cemilkendir/isolated-usb-rs485-rs422-converter/A2_Hardware/PCB_0110_01_AA/out/40_Mechanical/001_Render.jpg

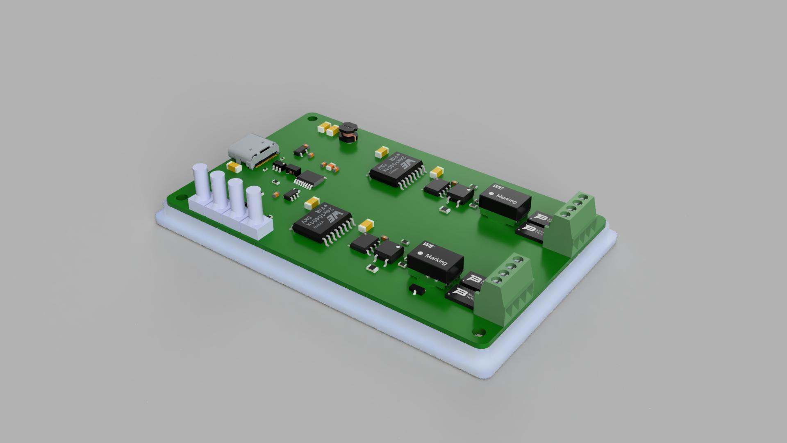
A2_Hardware/PCB_0110_01_AA/out/40_Mechanical/001_Render.jpg
