cemilkendir/isolated-usb-rs485-rs422-converter/A2_Hardware/PCB_0110_01_AA/README/Image/1.PNG

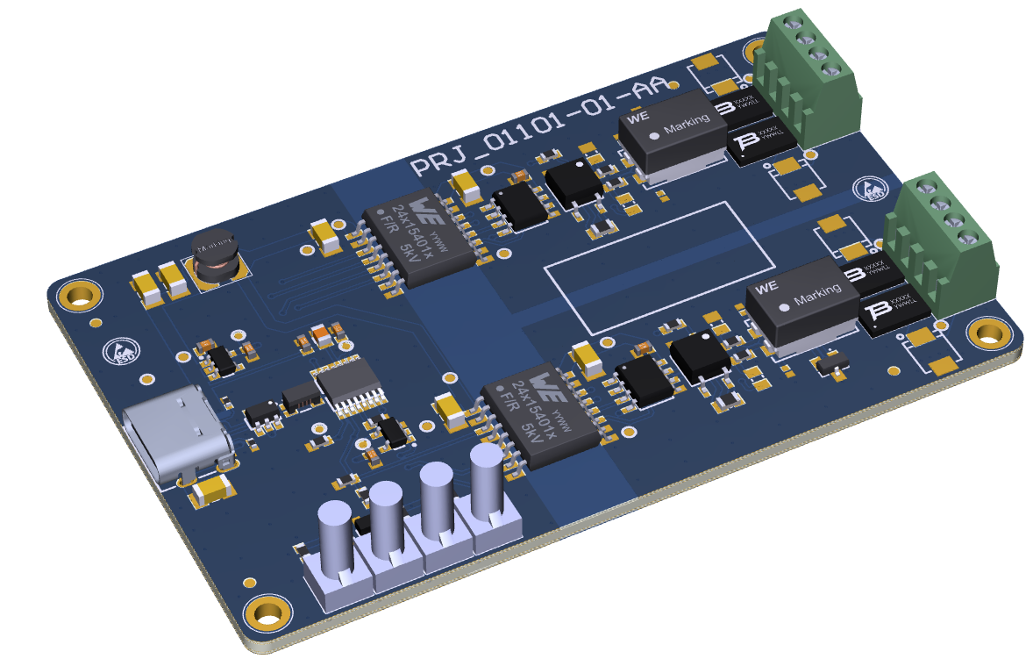
A2_Hardware/PCB_0110_01_AA/README/Image/1.PNG
