cemilkendir/isolated-usb-rs485-rs422-converter/A3_Mechanic/MCH_0110_01_AA/Pic/005_.PNG

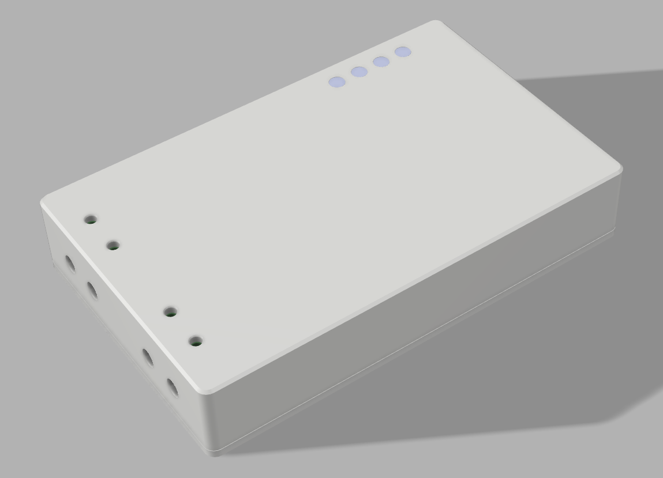
A3_Mechanic/MCH_0110_01_AA/Pic/005_.PNG
