cemilkendir/isolated-usb-rs485-rs422-converter/A2_Hardware/PCB_0110_01_AA/out/10_Bom/BOM_PRJ_01101_01_AAAA.xlsx

Sheet: Project Information
 | SCGC Electronics
USB to RS485_RS422 Converter
Tarih / Date
2026-10-11
23:55:34
PBA Informations
Project Name | USB to RS485_RS422 Converter
Description | USB to RS485_RS422 Converter
Document Number | PRJ_01101
Variant | AA
Release Date | 09/2026
PBA Responsibilities
Drawn by | Cemil Kendir
Checked by | Cemre Kendir
Approved by | Suheyla Inal KENDİR

Sheet: Part List Report
SCGC Electronics |  |  |  | PBA Description: | USB to RS485_RS422 Converter |  |  | Variant: | AA
 |  |  |  | Project Code: | PRJ_0110_AA.PrjPCB |  |  | Total Part Cost:
NO | Stock ID | Purpose Of Usage | Category | Sub-Category | Description | Designator | Quantity | Manufacturer | Manufacturer Part Number | Supplier 1 | Supplier Part Number 1 | Mount | Layer
1 | ?? | BASIC, ISOLATOR | CAPASITOR | CERAMIC | 10UF, 16V, X7R, 1206 | C8, C9, C10_CH_1, C10_CH_2, C11_CH_1, C11_CH_2 | 6 | Samsung | CL31B106MOHNNNE | Digi-Key | 1276-6641-1-ND | SMD | Top
2 | ?? | USB_to_UART | CAPASITOR | CERAMIC | 1nF, 2kV, X7R, 1206 | C1 | 1 | Yageo | CS1206KKX7RDBB102 | Digi-Key | 13-CS1206KKX7RDBB102TR-ND | SMD | Top
3 | ?? | USB_to_UART | CAPASITOR | CERAMIC | 1uF, 50V, X7R, 0603 | C13, C14 | 2 | Yageo | CC0603KRX7R9BB105 | Digi-Key | 311-2082-2-ND | SMD | Top
4 | ?? | USB_to_UART | CAPASITOR | CERAMIC | 10uF ,10V ,X7R ,0805 | C2 | 1 | Yageo | CC0805KFX7R6BB106 | Digi-Key | 13-CC0805KFX7R6BB106CT-ND | SMD | Top
5 | ?? | USB_to_UART, BASIC, RS485 | CAPASITOR | CERAMIC | 100nF, 25V, X7R, 0603 | C3, C4, C7, C12_RS422, C12_RS485 | 5 | Yageo | CC0603KRX7R8BB104 | Digi-Key | 311-1341-1-ND | SMD | Top
6 | ?? | BASIC | CONNECTORS | TERMINAL BLOCK | WR-TBL Terminal block - Rising Cage - THT | CON2, CON3 | 2 | Wurth Elektronik | 691210910004 | Digi-Key | 732-691210910004-ND | SMD | Top
7 | ?? | USB_to_UART | CONNECTORS | USB Type-C | Wr-com_usb 2.0_TYPE C_horizontal | CON1 | 1 | Wurth Elektronik | 629722000214 | Digi-Key | 732-629722000214TR-ND | SMD | Top
8 | ?? | USB_to_UART | DIODE | TVS | WURTH ELEKTRONIK - 824015 - TVS Diode, 82401 Series, Bidirectional, 5 V, 13 V, SOT-23, 6 Pins | TVS3 | 1 | Wurth Electronics | 824015 | Digi-Key | 732-4467-1-ND | SMD | Top
9 | ?? | USB_to_UART | DIODE | LED | LED GREEN CLEAR CHIP SMD | LED1 | 1 | Vishay Lite-On | LTST-C171GKT | Digi-Key | 160-1423-1-ND | SMD | Top
10 | ?? | USB_to_UART | DIODE | LED | LED RED CLEAR SMD | LED2, LED4 | 2 | Vishay Lite-On | LTST-C171KRKT | Digi-Key | 160-1427-1-ND | SMD | Top
11 | ?? | USB_to_UART | DIODE | LED | LED BLUE CLEAR CHIP SMD | LED3 | 1 | Vishay Lite-On | LTST-C171TBKT | Digi-Key | 160-1645-1-ND | SMD | Top
12 | ?? |  | INDUCTORS | FIXED INDUCTORS | WE-PD2, Unshielded Wire-wound SMD Inductor With Ferrite Core, 4.7 Uh, 1.82A I | L1 | 1 | Wurth Elektronik | 744773047 | Digi-Key | 732-1252-1-ND | SMD | Top
13 | ?? | RS485 | INDUCTORS | COMMON MODE CHOKES | Common Mode Chokes Dual 1000uH 6kOhm 100kHz 0.8A 0.207Ohm DCR SMD T/R Automotive AEC-Q200 | CM1_RS422, CM1_RS485 | 2 | Wurth Elektronik | 744222 | Digi-Key | 732-1485-1-ND | SMD | Top
14 | ?? | USB_to_UART | INDUCTORS | COMMON MODE CHOKES | Common Mode Chokes Dual 90Ohm 100MHz 370mA SMD T/R | CM2 | 1 | Wurth Electronics | 744232090 | Digi-Key | 732-1469-1-ND | SMD | Top
15 | ?? | BASIC | INTEGRATED CIRCUITS | LOGIC | MC74VHC1G08 Series 2 to 5.5 SMT Single 2 Input AND Gate - SOT-23-5 | IC3 | 1 | ON Semiconductor | MC74VHC1G08DTT1G | Digi-Key | MC74VHC1G08DTT1GOSTR-ND | SMD | Top
16 | ?? | ISOLATOR | INTEGRATED CIRCUITS | ISOLATOR | WPME-CDIP Capacitive Digital Isolator Powered | IC4_CH_1, IC4_CH_2 | 2 | Wurth Elektronik | 18024115401H | Digi-Key | 732-18024115401HTR-ND | SMD | Top
17 | ?? | RS485 | INTEGRATED CIRCUITS | RS485 DRIVER | 3.0 V to 5.5 V, ±12 kV IEC ESD Protected, Half Duplex 50 Mbps RS-485 Transceiver | IC2_RS422, IC2_RS485 | 2 | Analog Devices | ADM3065EARZ-R7 | Digi-Key | 505-ADM3065EARZ-R7TR-ND | SMD | Top
18 | ?? | RS485 | INTEGRATED CIRCUITS | SOLID STATE RELAY | 1 FORM A SOLID STATE RELAY Transistor Output SSR, 1-Channel, 3750V Isolation | IC5_RS422, IC5_RS485 | 2 | Vishay | VO1400AEFTR | Digi-Key | VO1400AEFTR-ND | SMD | Top
19 | ?? | USB_to_UART | INTEGRATED CIRCUITS | USB to UART | USB Interface IC USB to Basic Serial UART IC SSOP-16 | IC1 | 1 | FTDI | FT230XS-U | Digi-Key | 768-1154-5-ND | SMD | Top
20 | ?? | USB_to_UART | INTEGRATED CIRCUITS | PMIC - LINEAR REGULATOR | Linear Voltage Regulator IC Positive Fixed 1 Output 250mA SOT-23-5 | IC6 | 1 | TEXAS | LP5907MFX-3.3/NOPB | Digi-Key | 296-38557-2-ND | SMD | Top
21 | ?? | BASIC | MECHANICAL | PCB | PCB | PCB1 | 1 | CUSTOM | CUSTOM | CUSTOM | CUSTOM | MECH | Top
22 | ?? | USB_to_UART | MECHANICAL | LED PIPE | Bivar straight light guide, rigidity, PCBinstall, 4.1 x 4.1 x 10.2mm | MCH1, MCH2, MCH3, MCH4 | 4 | Bivar | VLP-400-F | Digi-Key | 492-1516-ND | MECH | Top
23 | ?? | RS485 | PROTECTION | TVS - BI DIRECTIONAL | SM Series 12 V 400 W Asymmetrical TVS Diode for Extended Common-Mode - SOT-23 | TVS1_RS422, TVS1_RS485 | 2 | Semtech | SM712.TCT | Digikey | SM712CT-ND | SMD | Top
24 | ?? | RS485 | PROTECTION | TBU | A Single Bi-Directional, 650V, 200mA, 3-Pin DFN pkg TBU | Bourns TBU-CA065-200-WH | TBU1_RS422, TBU1_RS485, TBU2_RS422, TBU2_RS485 | 4 | Bourns | TBU-CA065-200-WH | Digikey | TBU-CA065-200-WHTR-ND | SMD | Top
25 | ?? | RS485 | RESISTOR | CHIP RESISTOR | 0R ,%1 ,1/10 W ,0603 | R8_RS422, R8_RS485, R9_RS422, R9_RS485 | 4 | YAGEO | RC0603FR-070RL | Digi-Key | 311-0.0HRCT-ND | SMD | Top
26 | ?? | RS485 | RESISTOR | CHIP RESISTOR | 120R, %5, 1/8W, 0805 | R7_RS422, R7_RS485 | 2 | YAGEO | RC0805JR-07120RL | Digi-Key | 311-120ARCT-ND | SMD | Top
27 | ?? | RS485 | RESISTOR | CHIP RESISTOR | 400R, %0.1, 1/8W, 0603 | R11_RS422, R11_RS485 | 2 | Vishay Dale Thin Film | PAT0603E4000BST1 | Digi-Key | PAT0603E4000BST1 | SMD | Top
28 | ?? | USB_to_UART | RESISTOR | CHIP RESISTOR | 5.1K, %1, 1/16W, 0402 | R1, R2 | 2 | YAGEO | RC0402FR-075K1L | Digi-Key | 311-5.10KLRTR-ND | SMD | Top
29 | ?? | USB_to_UART | RESISTOR | CHIP RESISTOR | 10K, %1, 1/10W, 0603 | R13, R14, R15, R16 | 4 | YAGEO | RT0603FRE0710KL | Digi-Key | YAG2321CT-ND | SMD | Top
30 | ?? | USB_to_UART | RESISTOR | CHIP RESISTOR | 220R, %1, 1/10W, 0603 | R3, R4, R5, R12 | 4 | YAGEO | RC0603FR-07220RL | Digi-Key | 311-220HRCT-ND | SMD | Top
31 | ?? | USB_to_UART | TRANSISTOR | NPN | TRANS NPN 45V 0.1A SOT23 | TR1 | 1 | Nexperia | BC847,215 | Digi-Key | 1727-4855-1-ND | SMD | Top
