cemilkendir/isolated-usb-rs485-rs422-converter/A3_Mechanic/MCH_0110_01_AA/MECH/Assembly.step

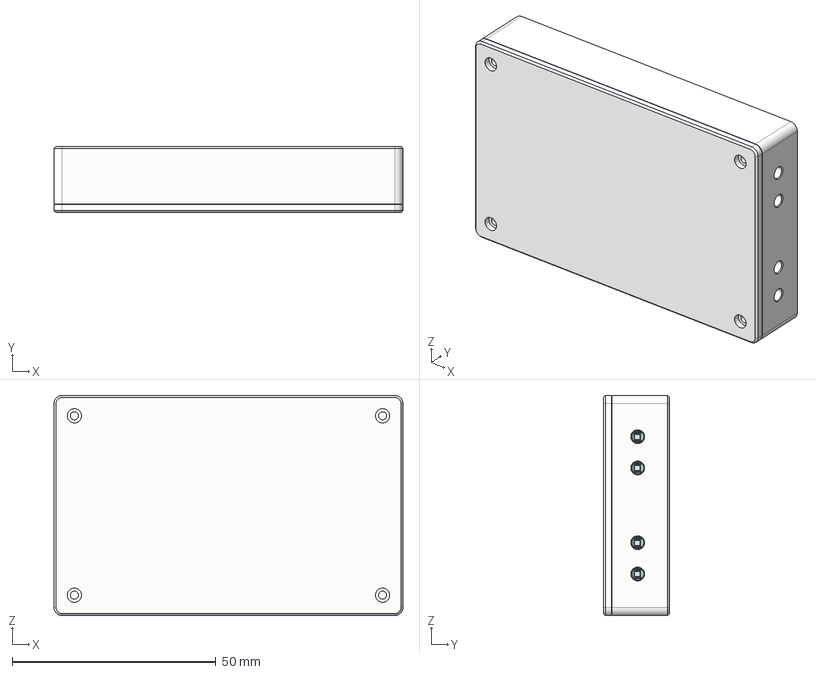
[picture p19: CAD file, 2026-10-11]
A3_Mechanic/MCH_0110_01_AA/MECH/Assembly.step
85.6 x 16.2 x 54.0 mm
BottomCover
6912109100xx_CAGE x 8
6912109100xx_PIN x 8
6912109100xx_VIS x 8
R0603 x 14
SOT-23
tbu-ca x 4
SMD_0402 x 6
ap2112k-3_3trg1 x 2
C0603 x 7
VLP-400-F_1 x 4
Red_0805 x 2
User Library-4-SOP_1 x 2
User Library-4-SOP_2 x 2
User Library-4-SOP_3 x 2
User Library-4-SOP_4 x 2
User Library-4-SOP_5 x 2
User Library-4-SOP_6 x 2
Lötfläche
Lötfläche_1
C1206 x 7
SOT23-6-2
Boden
Blue_0805
Green_0805
STEP-WE-TVS-SOT23-3L-rev1 x 2
R0805 x 2
Housing x 2
Pins x 2
SO8 x 2
SSOP-16_065mm
629722000214_Housing
629722000214_Pin1_Top
629722000214_Pin4_Bottom
629722000214_Pin4_Top x 2
629722000214_Pin1_Bottom
629722000214_Pin3_Bottom
629722000214_Pin3_Top
629722000214_Pin2_Top
629722000214_Pin2_Bottom
629722000214_Pin1_Top_mir
629722000214_Pin1_Bottom_mir
629722000214_Pin2_Top_mir
629722000214_Pin2_Bottom_mir
629722000214_Pin3_Top_mir
629722000214_Pin3_Bottom_mir
629722000214_Pin4_Bottom_mir
629722000214_Shielding2
629722000214_Shielding
Boden_1 x 2
Boden_2 x 2
Boden_3 x 2
Boden_4 x 2
Boden_5 x 2
Deckel x 2
C0805
TopCover
