cemilkendir/isolated-usb-rs485-rs422-converter/A2_Hardware/PCB_0110_01_AA/mech/SPD184.step

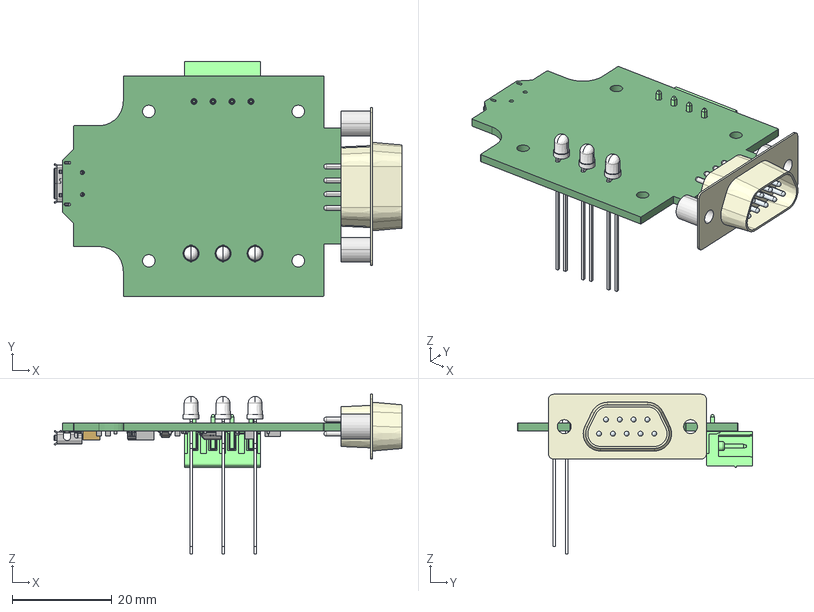
[picture p20: CAD file, 2026-10-05]
A2_Hardware/PCB_0110_01_AA/mech/SPD184.step
69.8 x 47.1 x 32.0 mm
