cemilkendir/isolated-usb-rs485-rs422-converter/A2_Hardware/PCB_0110_01_AA/mech/SPD184 TOP SSEKIL 10.01.2019.dxf

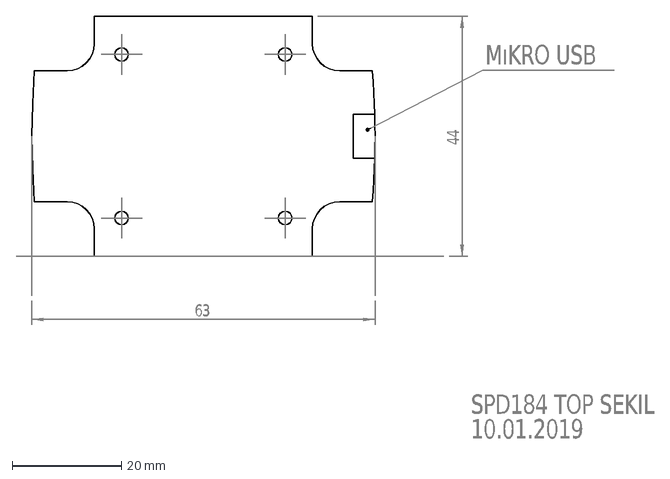
[picture p22: CAD file, 2026-10-05]
A2_Hardware/PCB_0110_01_AA/mech/SPD184 TOP SSEKIL 10.01.2019.dxf
SPD184 TOP SEKIL
10.01.2019
63
44
MıKRO USB
