cemilkendir/isolated-usb-rs485-rs422-converter/A2_Hardware/PCB_0110_01_AA/out/40_Mechanical/3D_Step_PRJ_01101_01_AAAB.step

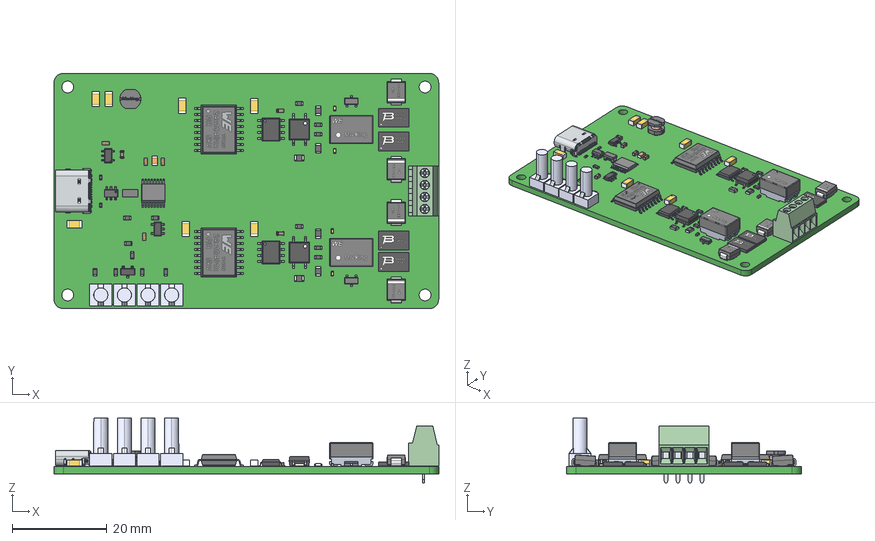
[picture p23: CAD file, 2026-10-05]
A2_Hardware/PCB_0110_01_AA/out/40_Mechanical/3D_Step_PRJ_01101_01_AAAB.step
81.5 x 49.8 x 13.7 mm
R0603 x 14
SOT-23
SMB_DO-214AA x 4
tbu-ca x 4
SMD_0402 x 6
ap2112k-3_3trg1 x 2
C0603 x 7
VLP-400-F x 4
Red_0805 x 2
User Library-4-SOP_1 x 2
User Library-4-SOP_2 x 2
User Library-4-SOP_3 x 2
User Library-4-SOP_4 x 2
User Library-4-SOP_5 x 2
User Library-4-SOP_6 x 2
Lötfläche x 2
C1206 x 7
SOT23-6-2
Boden x 11
Blue_0805
Green_0805
STEP-WE-TVS-SOT23-3L-rev1 x 2
R0805 x 6
Housing x 2
Pins x 2
SO8 x 2
SSOP-16_065mm
6912109100xx_CAGE x 4
6912109100xx_PIN x 4
6912109100xx_VIS x 4
629722000214_Housing
629722000214_Pin1_Top
629722000214_Pin4_Bottom
629722000214_Pin4_Top x 2
629722000214_Pin1_Bottom
629722000214_Pin3_Bottom
629722000214_Pin3_Top
629722000214_Pin2_Top
629722000214_Pin2_Bottom
629722000214_Pin1_Top_mir
629722000214_Pin1_Bottom_mir
629722000214_Pin2_Top_mir
629722000214_Pin2_Bottom_mir
629722000214_Pin3_Top_mir
629722000214_Pin3_Bottom_mir
629722000214_Pin4_Bottom_mir
629722000214_Shielding2
629722000214_Shielding
Deckel x 2
C0805
