cemilkendir/isolated-usb-rs485-rs422-converter/A2_Hardware/PCB_0110_01_AA/mech/HH-042.STEP

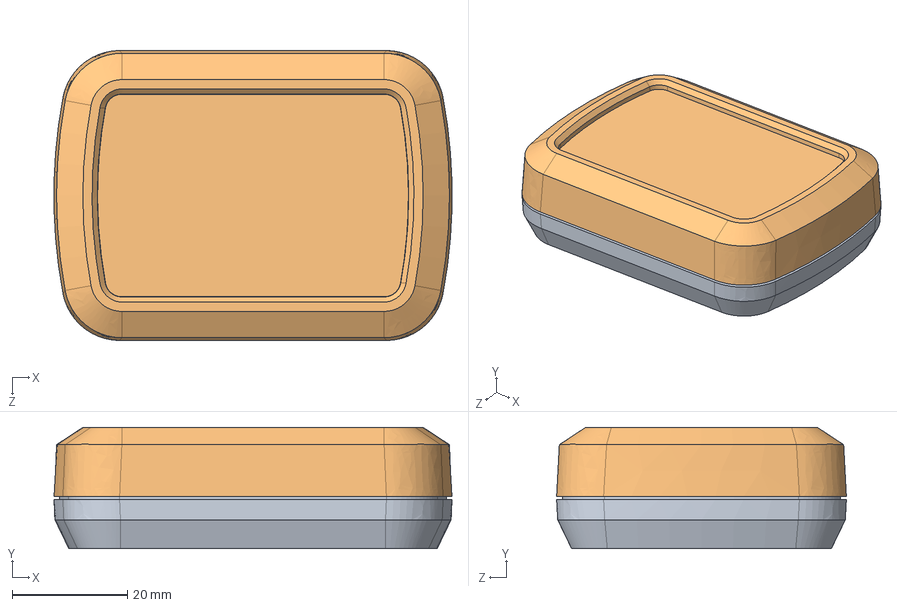
[picture p24: CAD file, 2026-10-05]
A2_Hardware/PCB_0110_01_AA/mech/HH-042.STEP
68.9 x 21.0 x 50.2 mm
HH-042-P-2
HH-042-P-1
