cemilkendir/isolated-usb-rs485-rs422-converter/A3_Mechanic/MCH_0110_01_AA/MECH/BottomCover.step

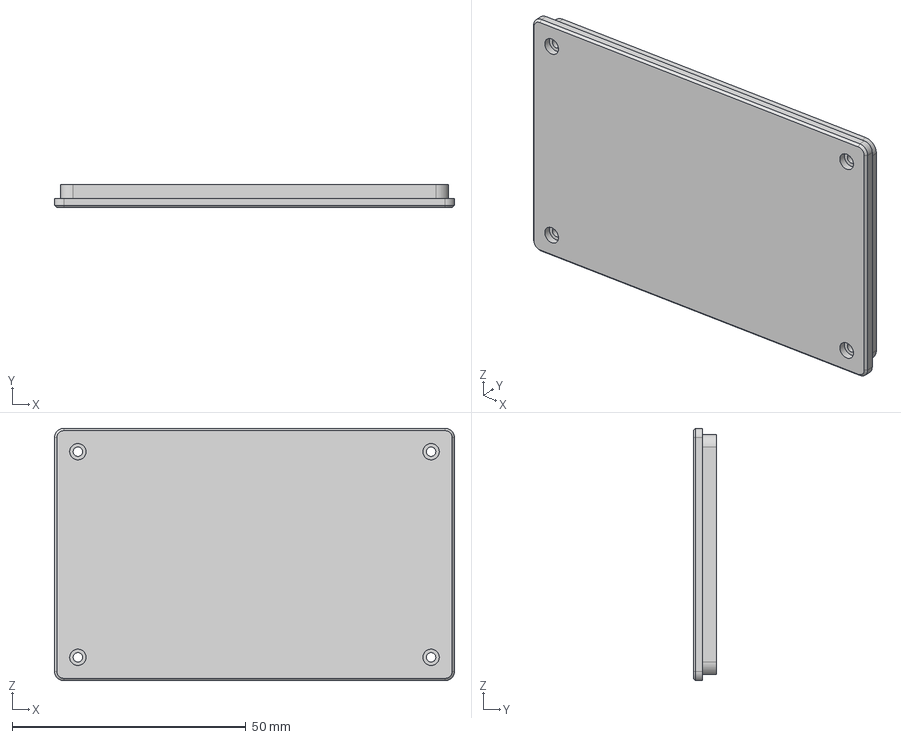
[picture p25: CAD file, 2026-10-11]
A3_Mechanic/MCH_0110_01_AA/MECH/BottomCover.step
85.6 x 5.00 x 54.0 mm
