cemilkendir/isolated-usb-rs485-rs422-converter/A3_Mechanic/MCH_0110_01_AA/MECH/TopCover.step

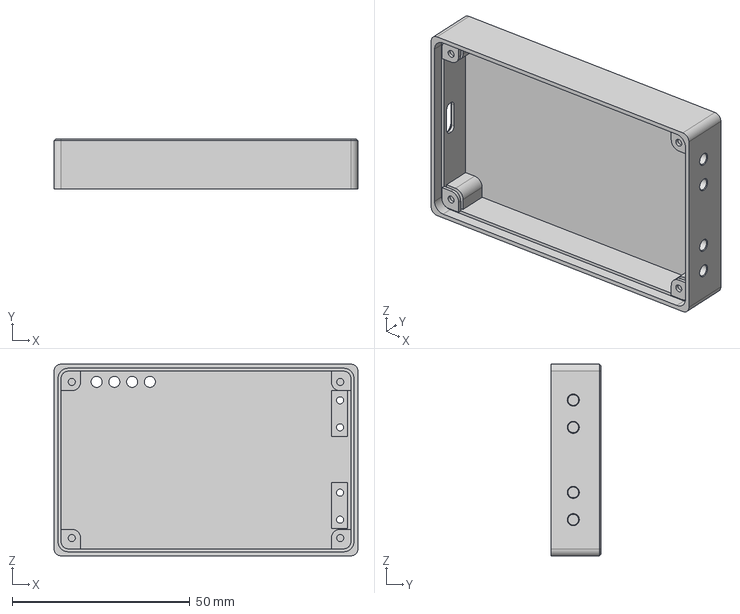
[picture p27: CAD file, 2026-10-11]
A3_Mechanic/MCH_0110_01_AA/MECH/TopCover.step
85.6 x 14.1 x 54.0 mm
