cemilkendir/isolated-usb-rs485-rs422-converter/A2_Hardware/PCB_0110_01_AA/mech/SPD184 KART TOP SEKIL 15.01.2020.dxf

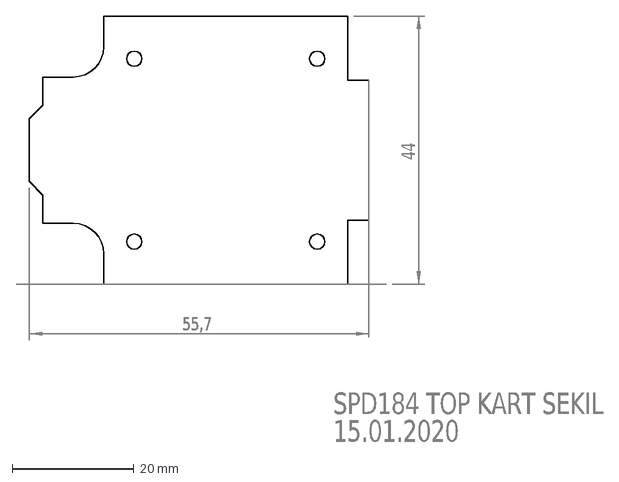
[picture p28: CAD file, 2026-10-05]
A2_Hardware/PCB_0110_01_AA/mech/SPD184 KART TOP SEKIL 15.01.2020.dxf
SPD184 TOP KART SEKIL
15.01.2020
55,7
44
