cemilkendir/isolated-usb-rs485-rs422-converter/(list of files, cad)

Other CAD files:
A3_Mechanic/MCH_0110_01_AA/MECH/3D_Step_PRJ_01101_01_AAAB.step
A2_Hardware/PCB_0110_01_AA/mech/SPD184.x_t
A2_Hardware/PCB_0110_01_AA/mech/SPD184_.step
