cemilkendir/isolated-usb-rs485-rs422-converter/A2_Hardware/PCB_0110_01_AA/out/00_SchPcbPdf/Sch_PRJ_01101_01_AAAA.PDF

D | D
C | C
B | B
A | A

## USB to RS485_RS422 Converter

Rev AA

Header.SchDoc

Sayfa/Sht | 1 | / 5
Form | A4

Tasa/Desig
Kont/Check | Cemre Kendir
Onay/Appr | Suheyla Inal KENDİR Cemil Kendir

## PRJ_01101

Altium Designer 23.9.2

Deg Tarihi/Chng Date

Ortam/Env

Deg Onay/Chng Appr | -
Tarih/Date | 09/2026
(c) 2022 by SCSG Elektronik A.Ş.
All rights Reserved. No part of this document may be produced or transmitted in any form or by any means electronic, mechanical, photocopying, recording, or otherwise, without prior written permission of SCSG.

# PROJECT OVERVIEW

# -This project implements a robust USB 2.0 to RS-485 / RS-422

communication interface intended for industrial and embedded applications.

# -The design provides two independently isolated communication channels for RS-485 and RS-422 operation. Interface selection does not require mechanical switches or jumpers. The receiver paths are automatically combined by utilizing the guaranteed fail-safe HIGH state of the

RS-485/RS-422 transceivers.

# -Galvanic isolation is provided for both communication signals and bus-side power. The RS-485 interface includes software-controlled 120 Ω termination

# USB 2.0 to Isolated RS-485 / RS-422 Converter

# KEY FEATURES

- USB 2.0 Full-Speed interface - FT230X USB-to-UART bridge supporting up to 3 Mbaud - Independent isolated RS-485 and RS-422 channels - ADM3065E true fail-safe RS-485/RS-422 transceivers - Automatic receive-path selection without mechanical switches - Integrated signal and power isolation - Software-controlled 120 Ω termination via RTS - Common-mode filtering on communication lines - Configurable external fail-safe biasing - Multi-stage RS-485 protection using SM712 + TBU - Optional thyristor surge protection stage - Protection and filtering components configurable for EMC optimization - USB-powered operation

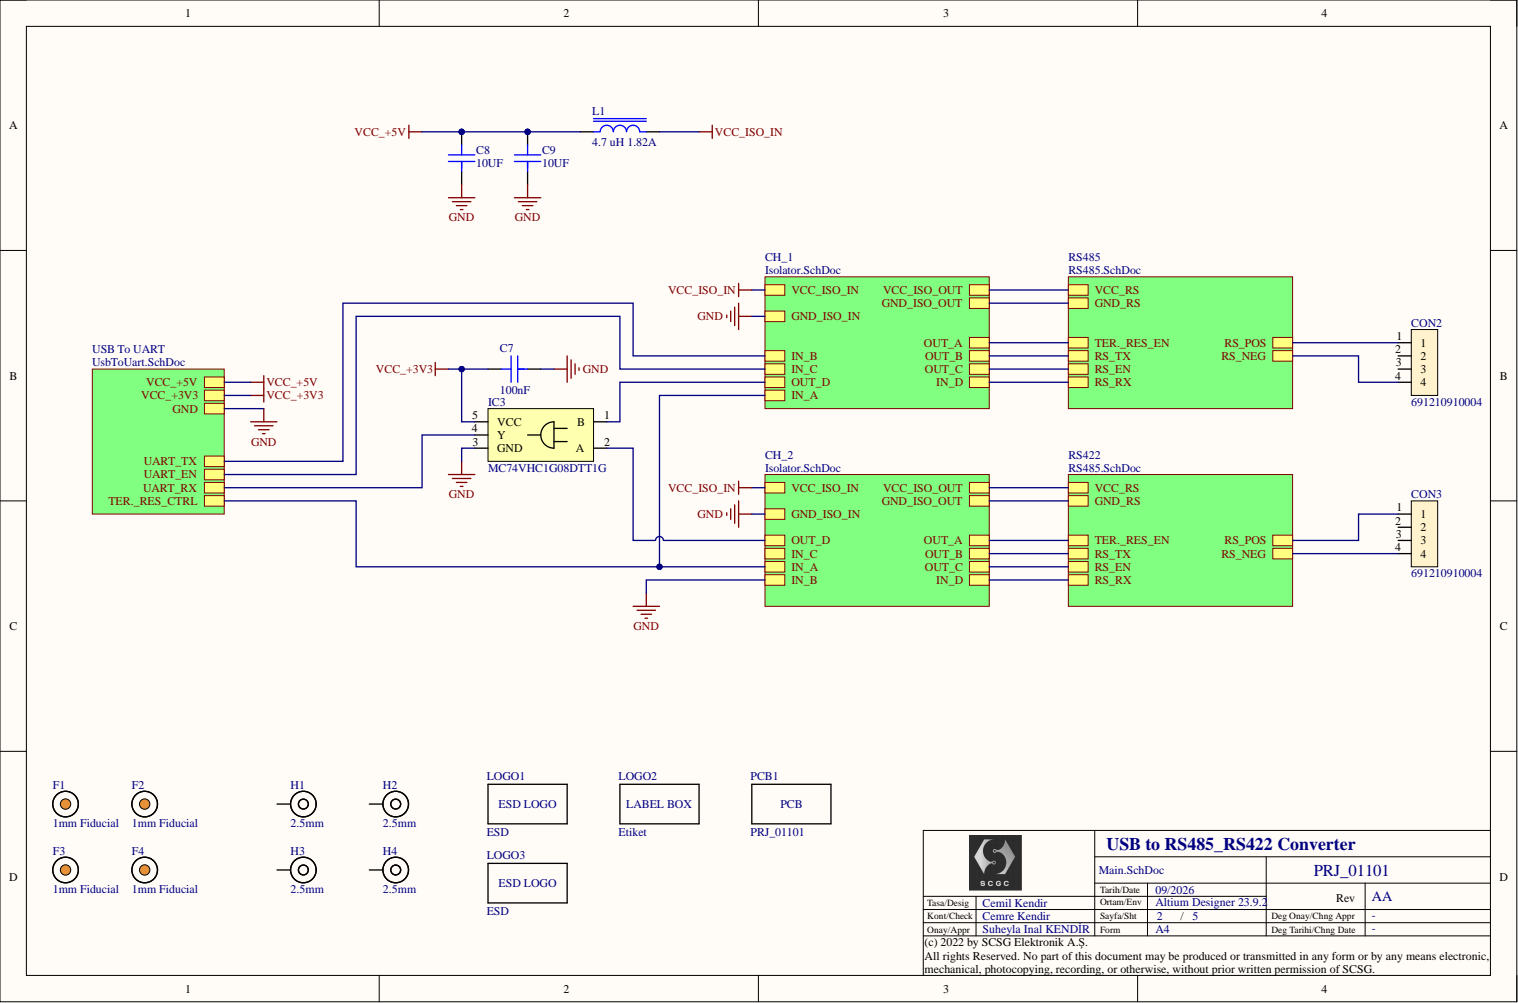
[picture p29: page 2]

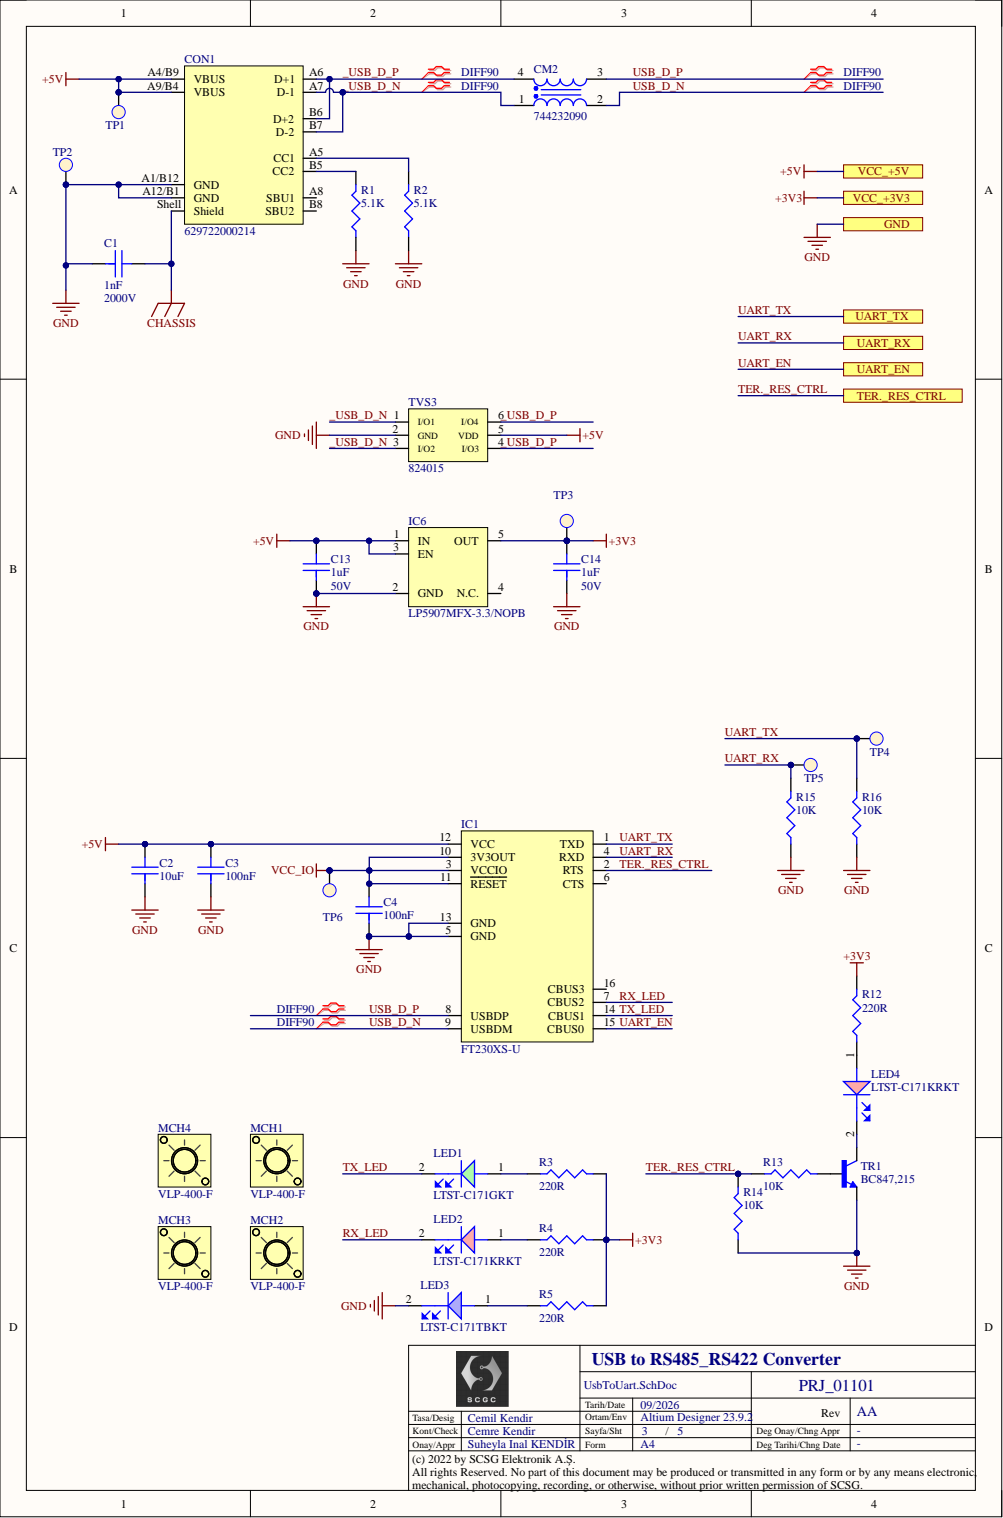
[picture p30: page 3]

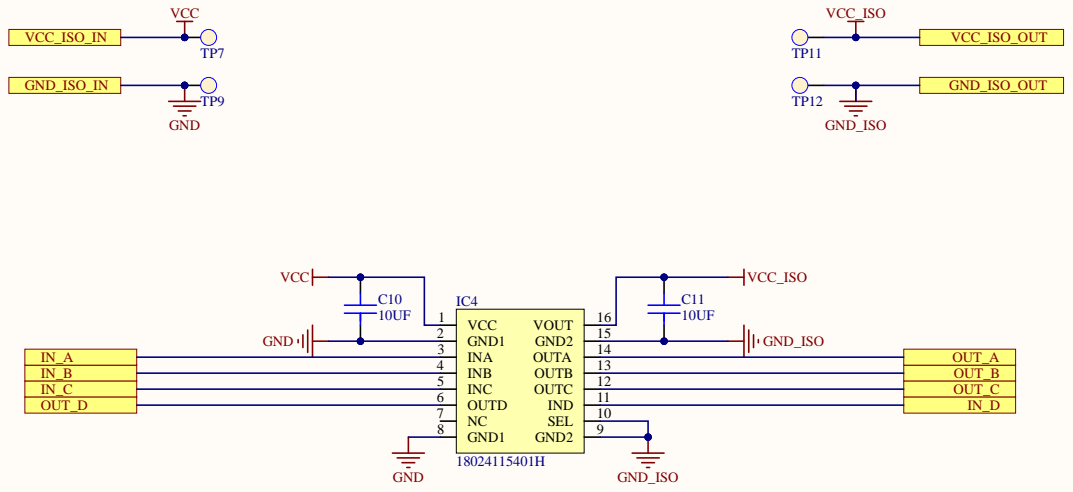
[picture p31: page 4]

IN_C | OUT_C
OUT_D | IN_D

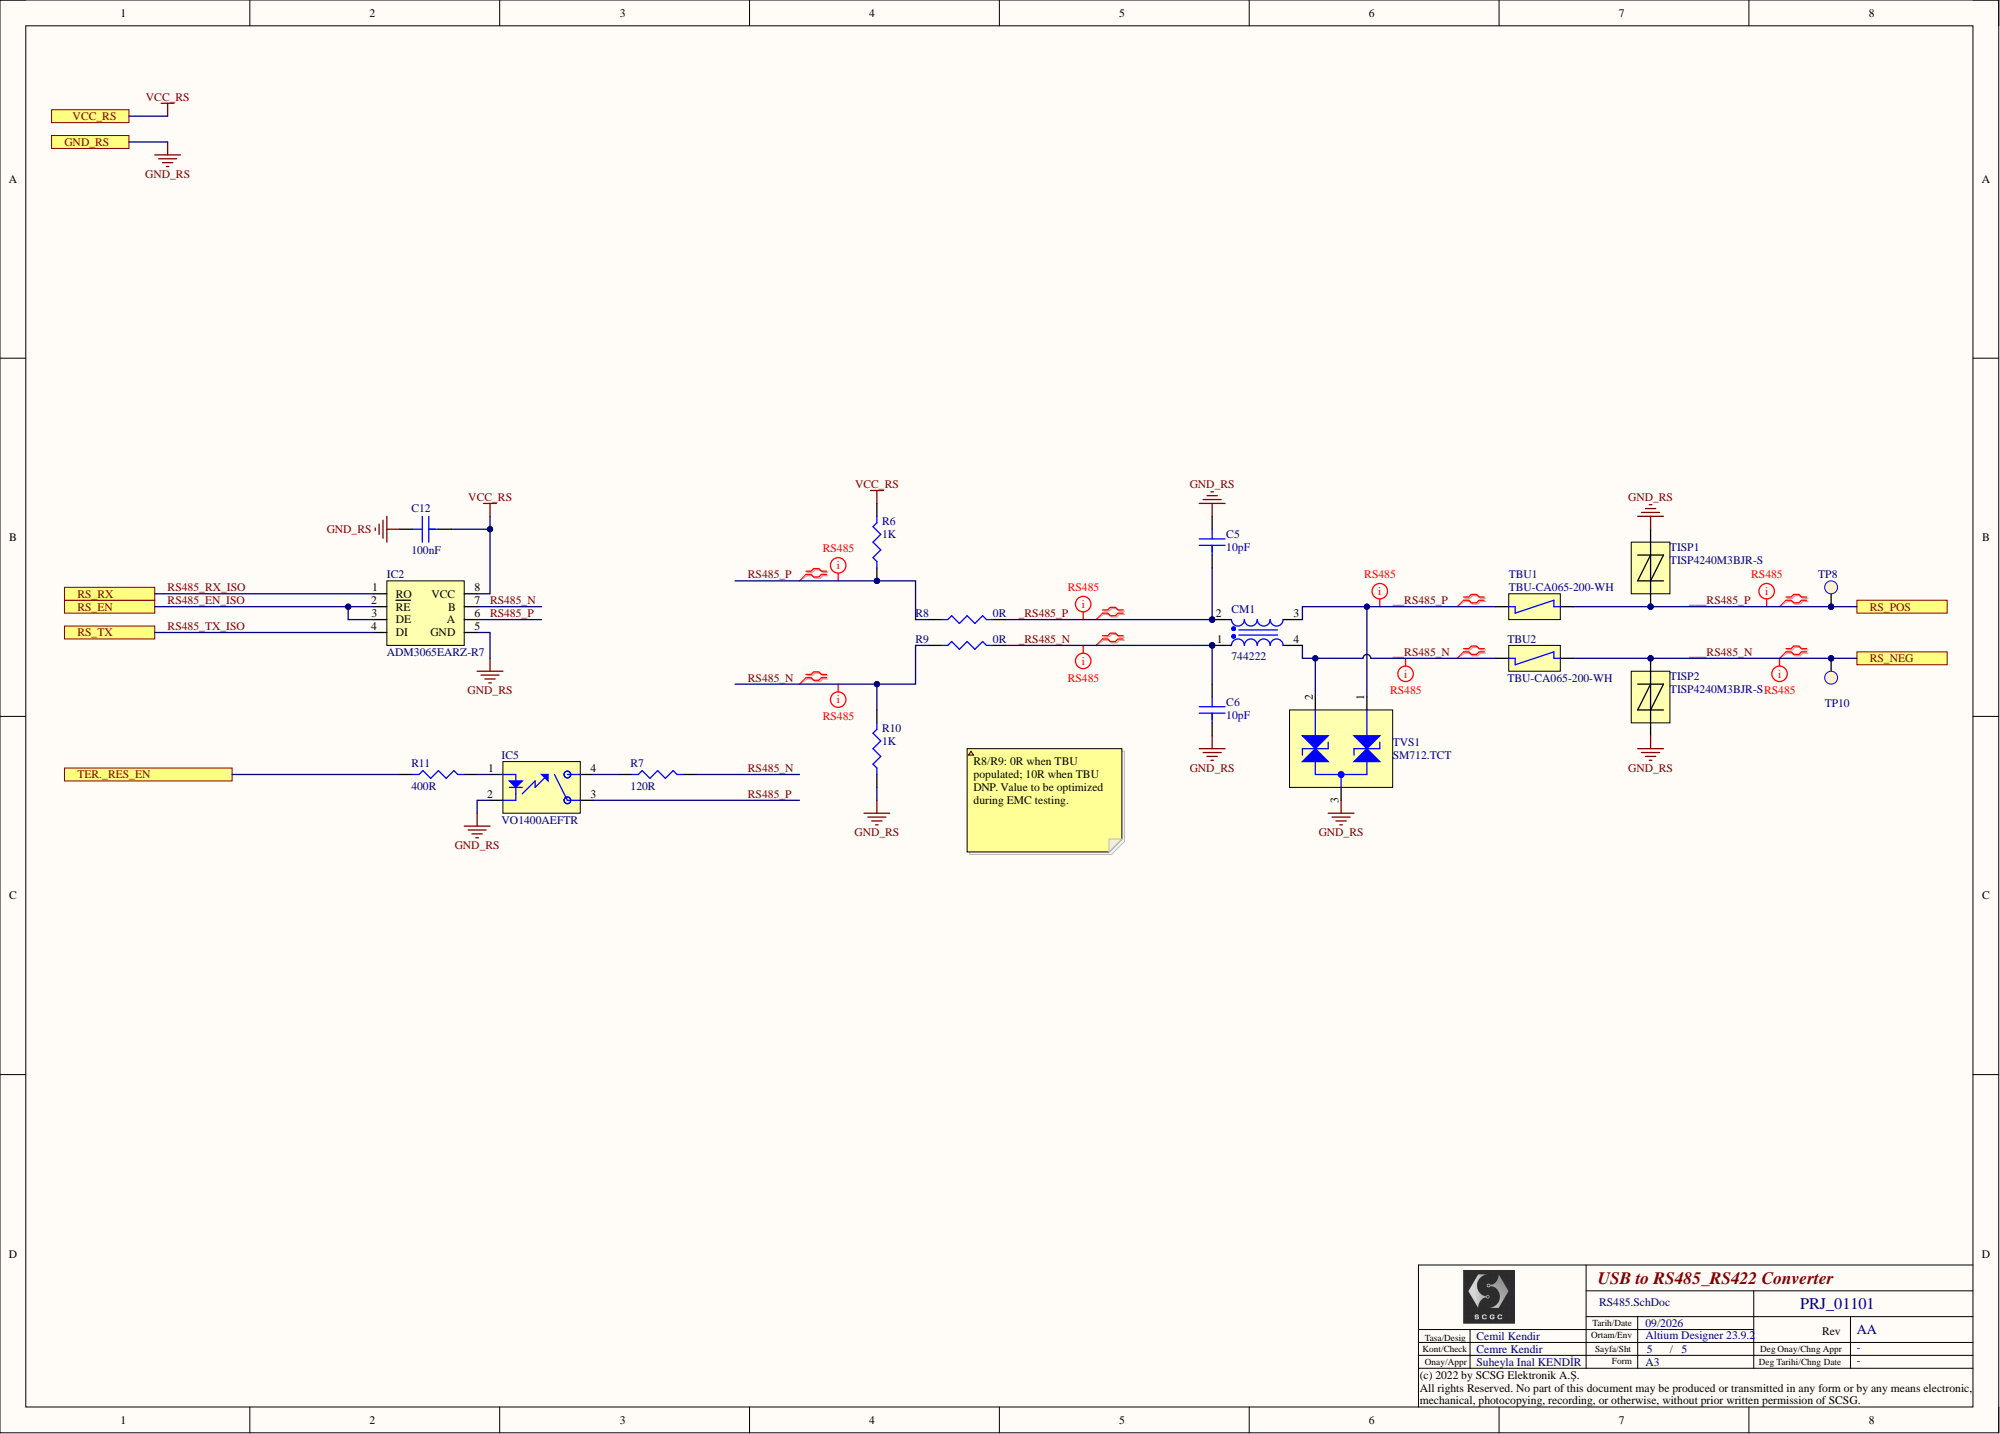
[picture p32: page 5]

R8/R9: 0R when TBU
populated; 10R when TBU
DNP. Value to be optimized
during EMC testing.
