cemilkendir/isolated-usb-rs485-rs422-converter/A2_Hardware/PCB_0110_01_AA/out/00_SchPcbPdf/PCB_PRJ_01101_01_AAAA.PDF

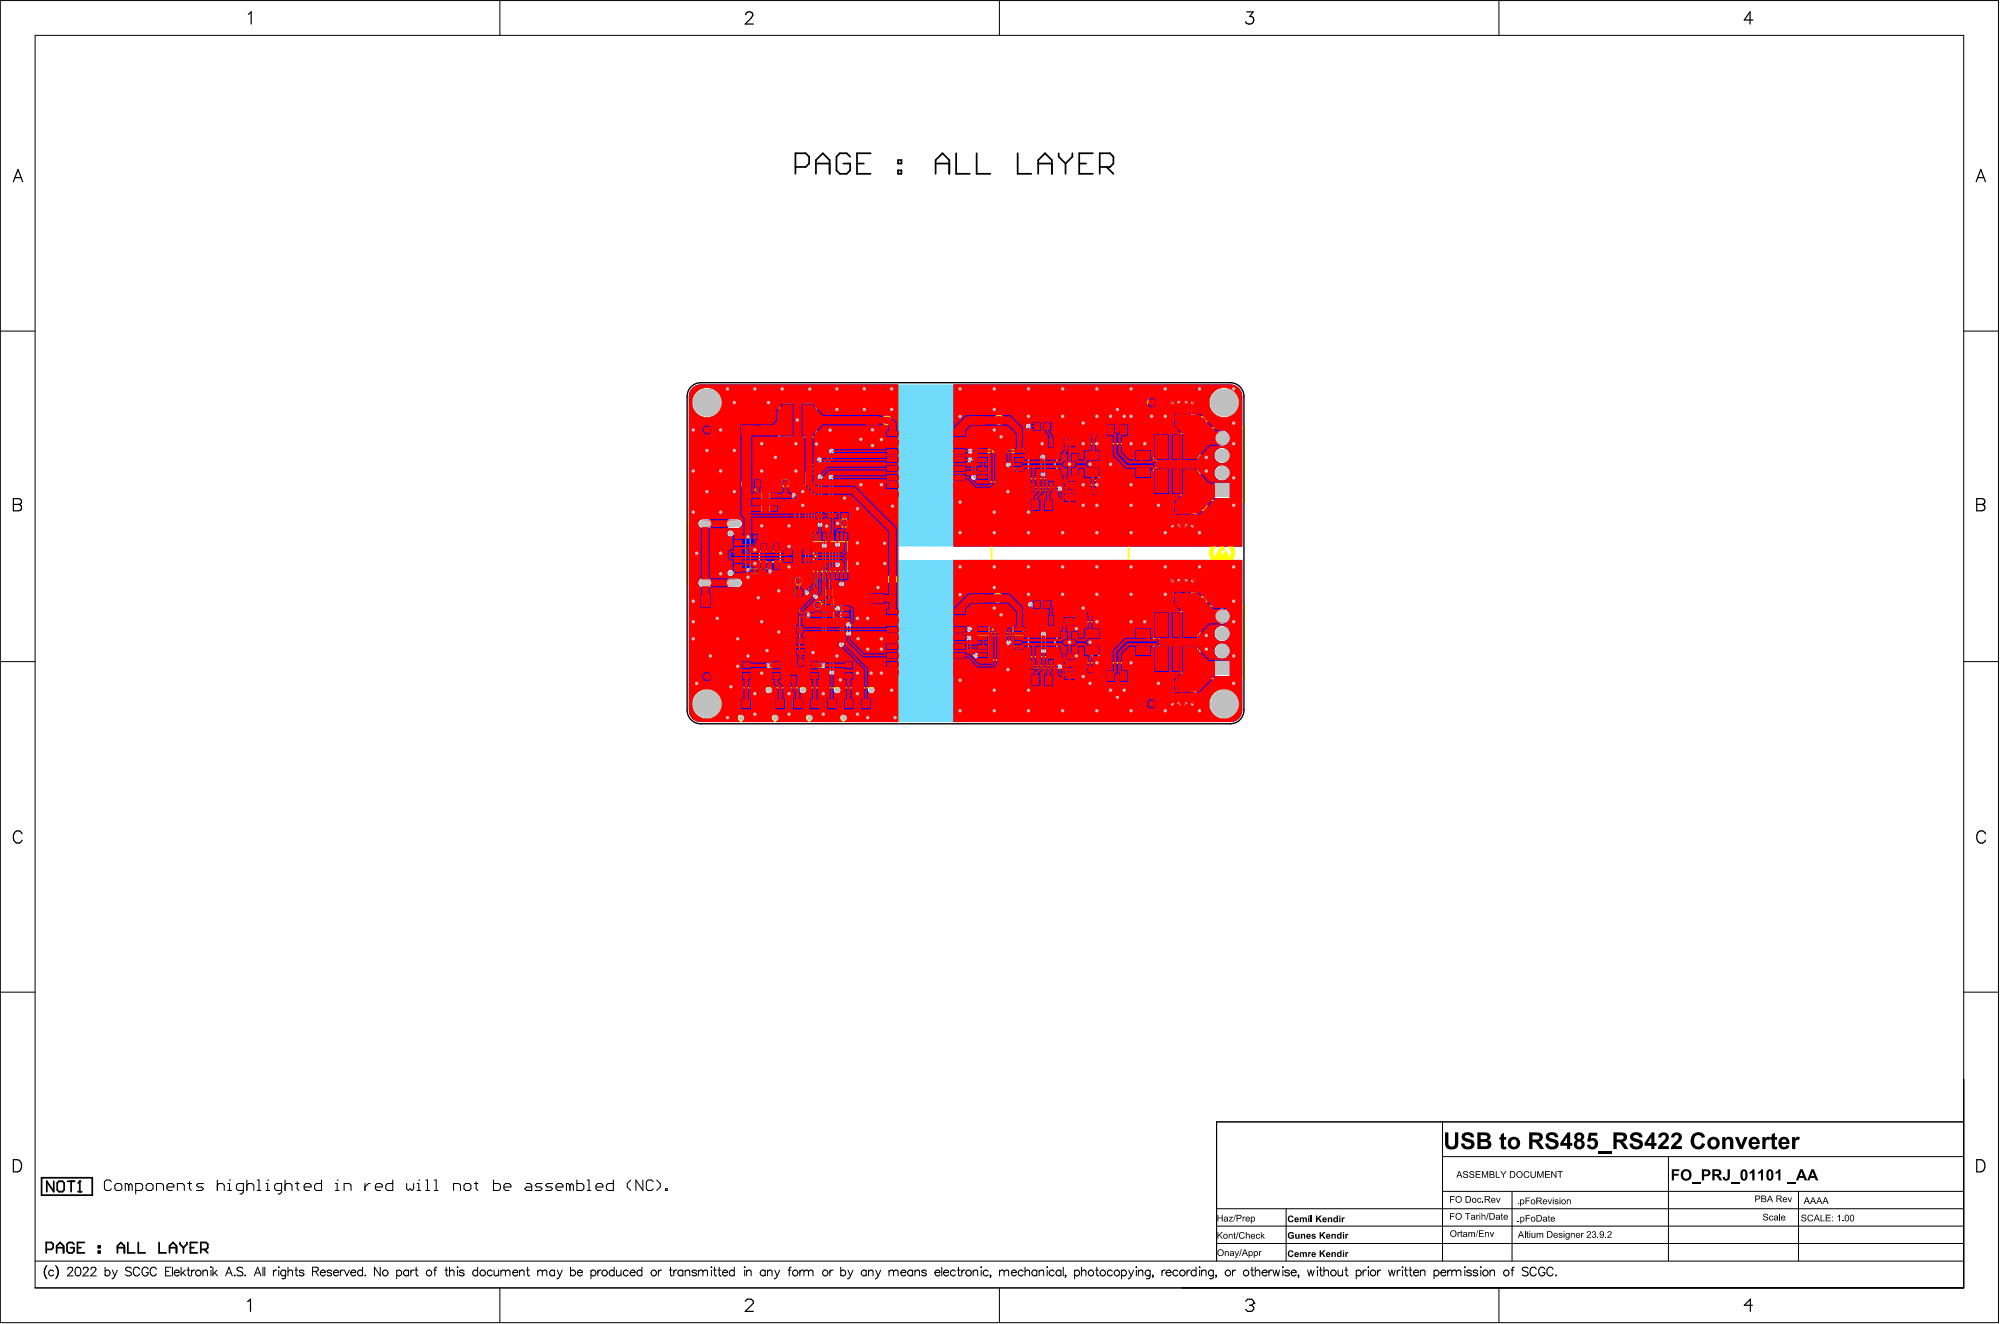
[picture p33: page 1]

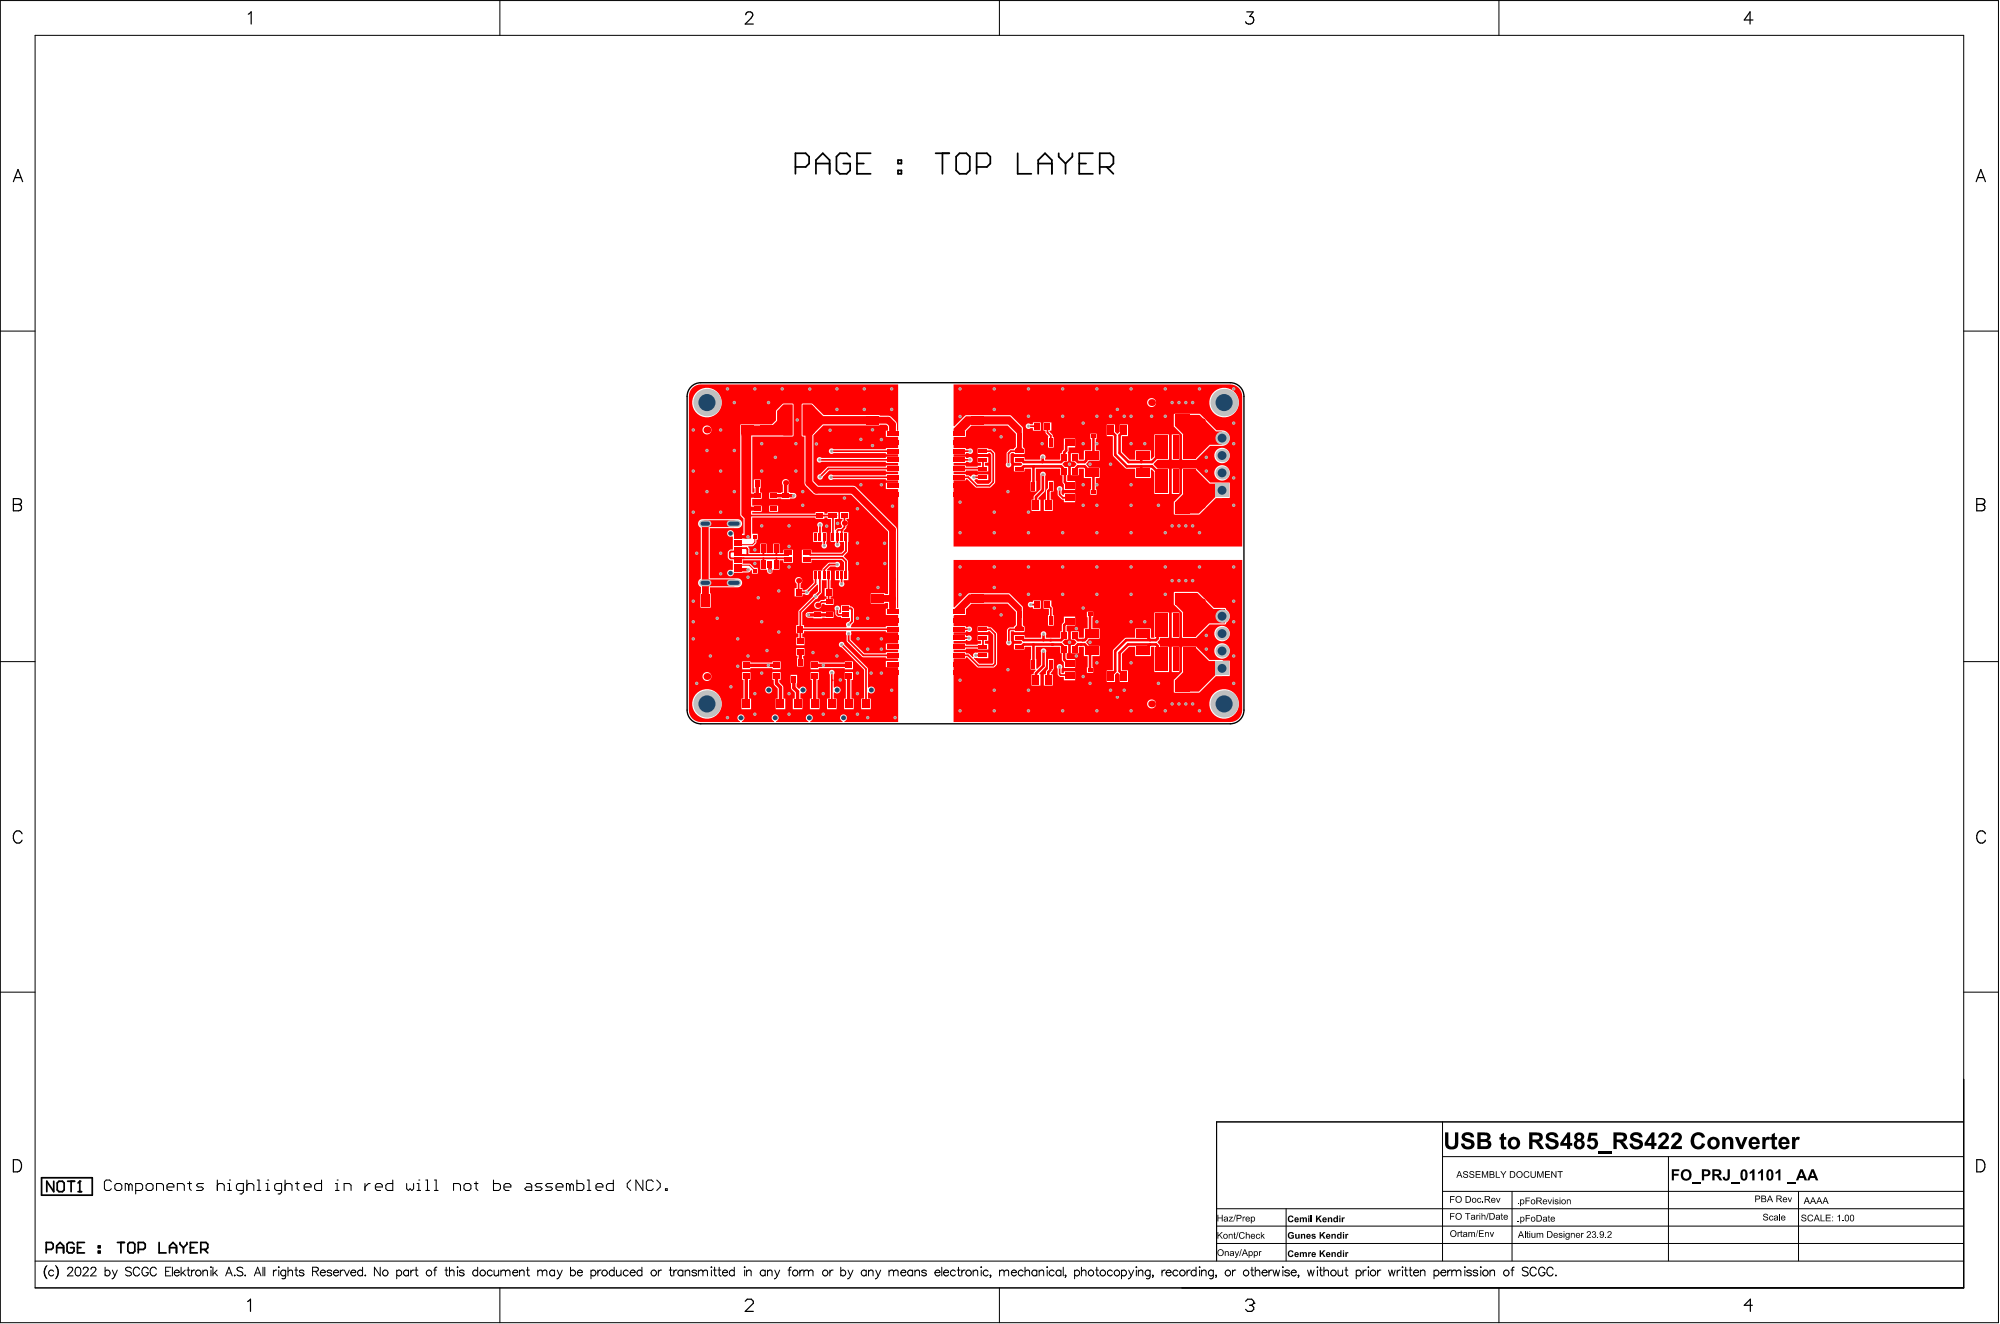
[picture p34: page 2]

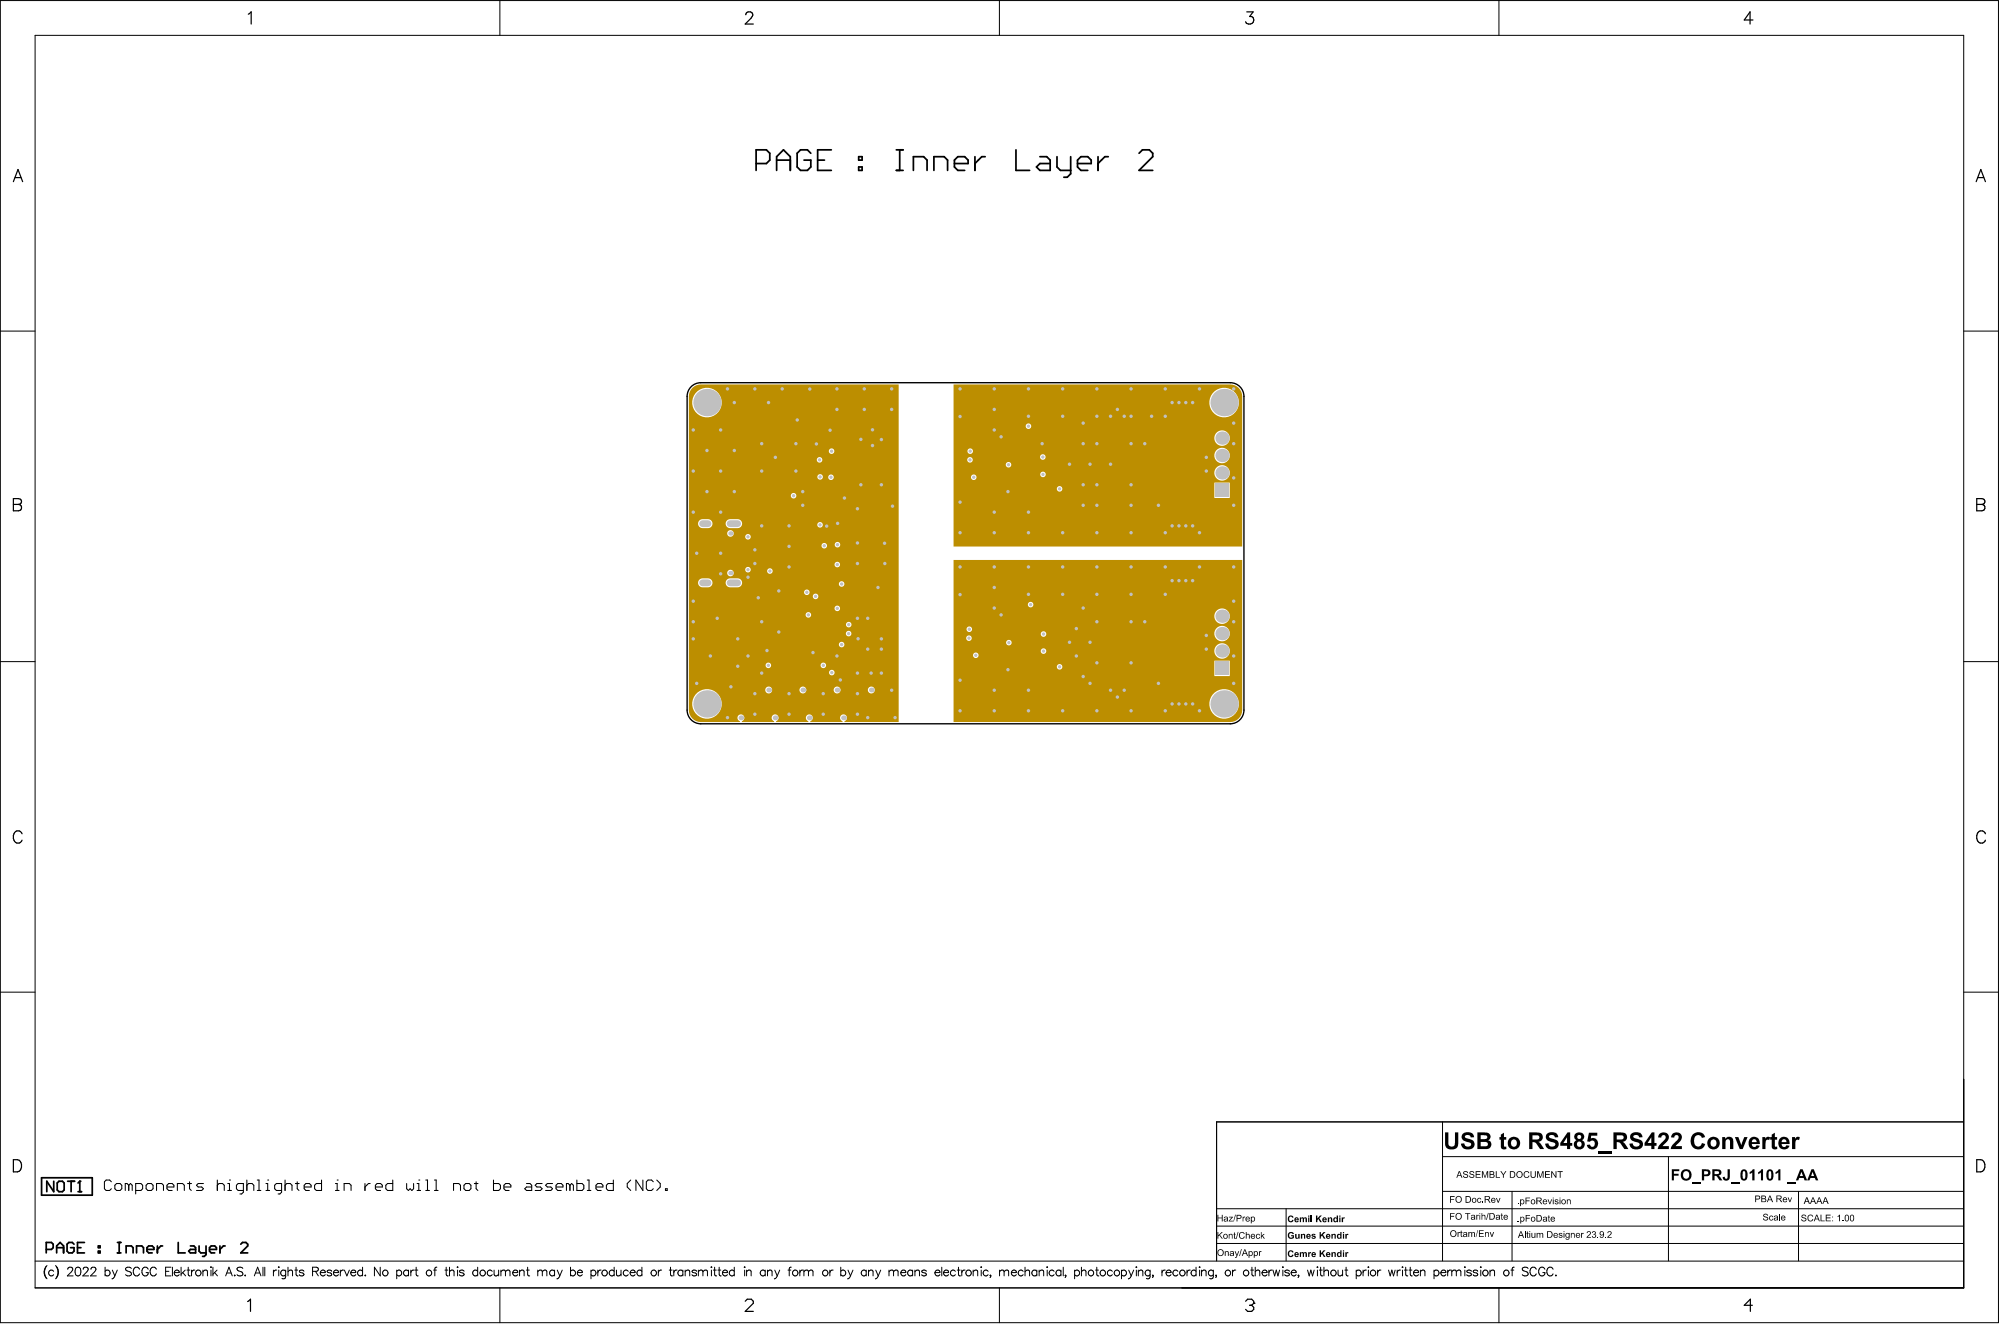
[picture p35: page 3]

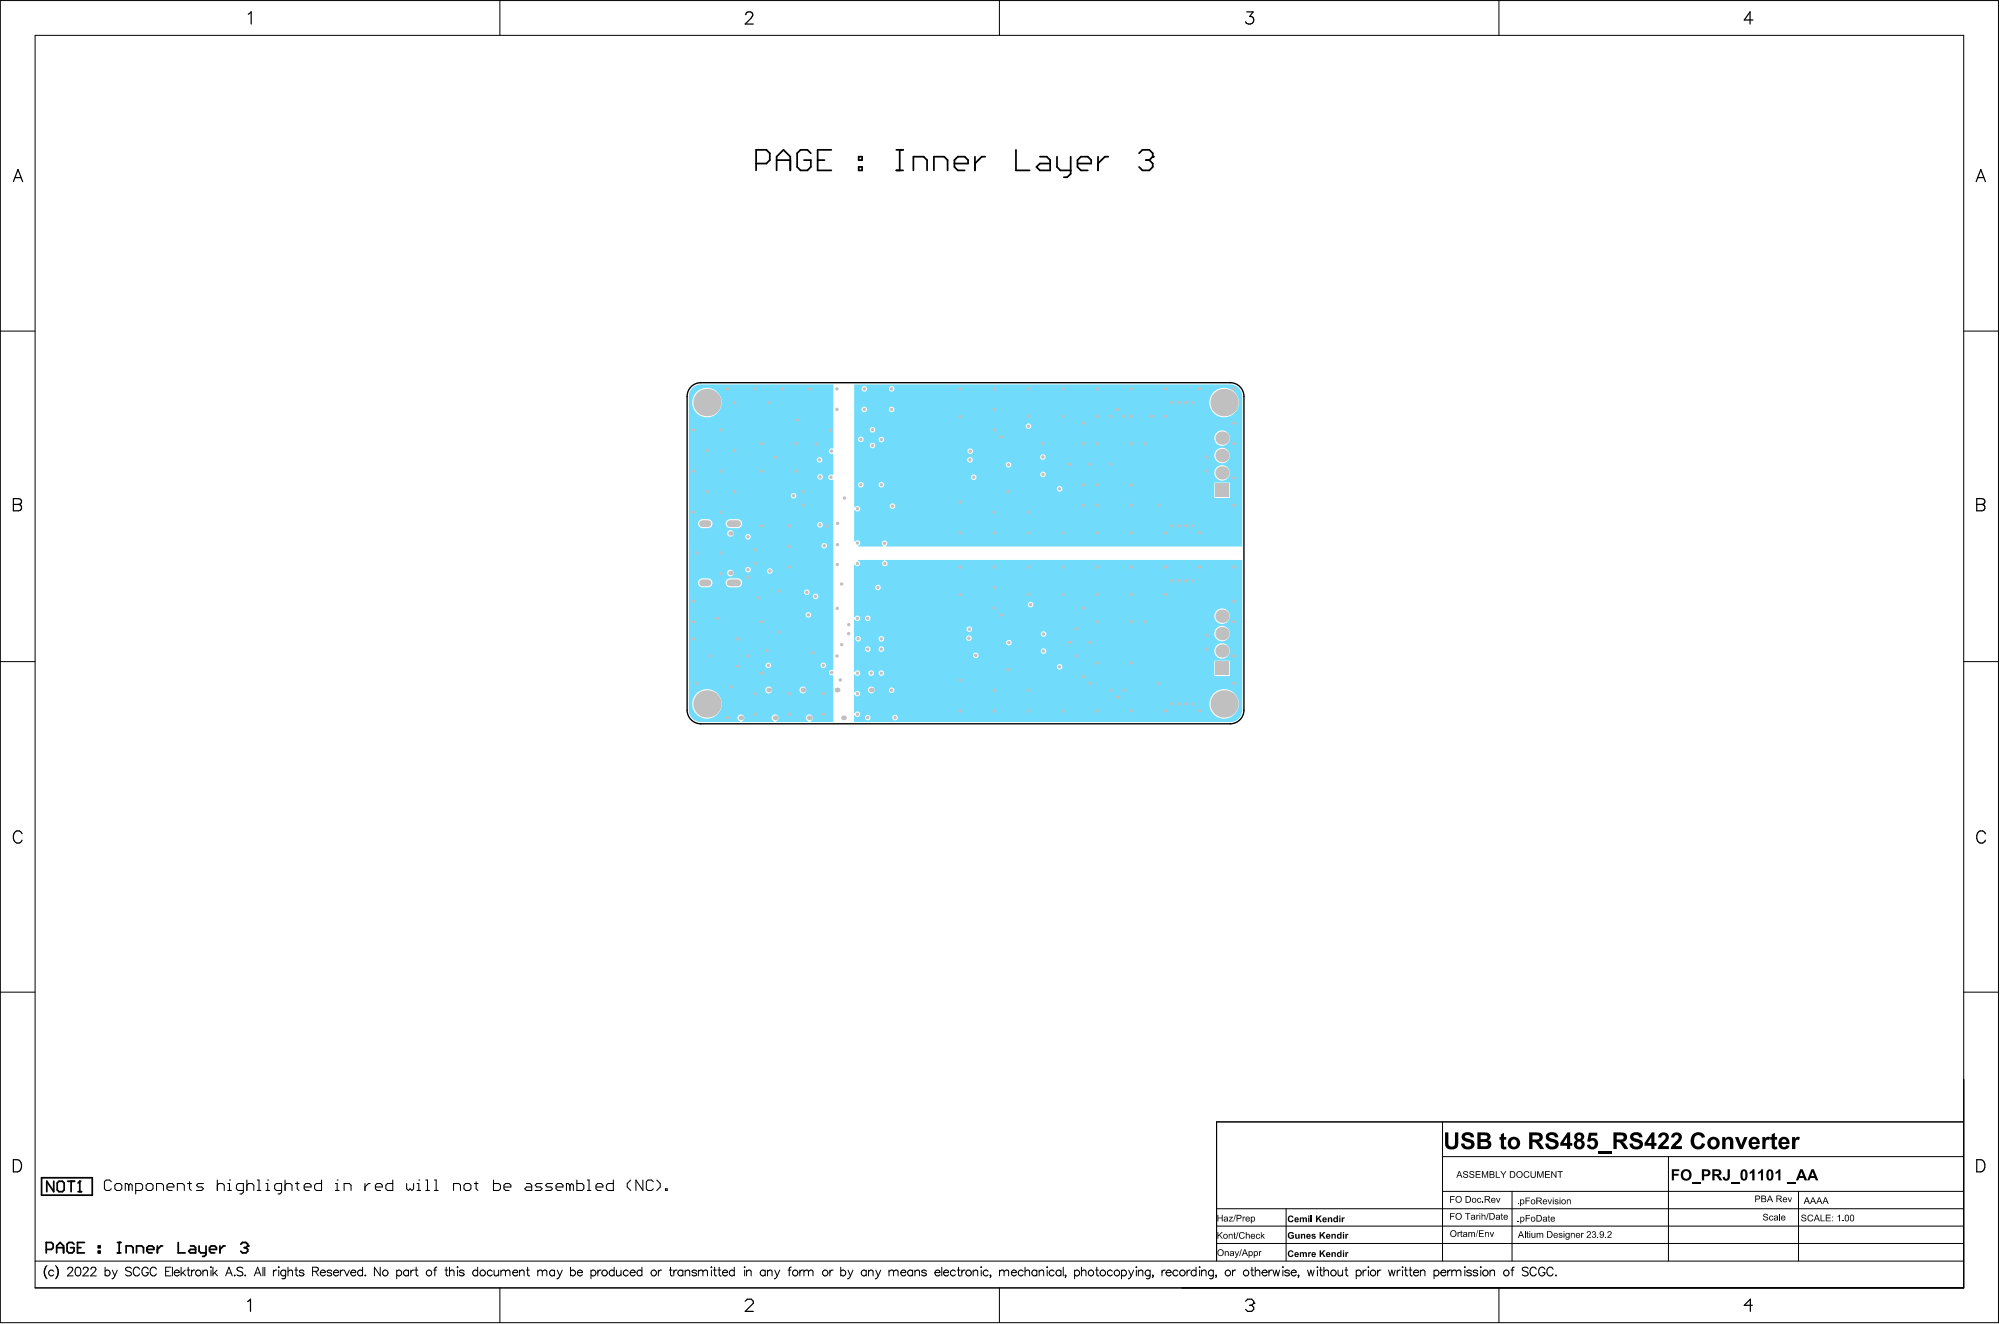
[picture p36: page 4]

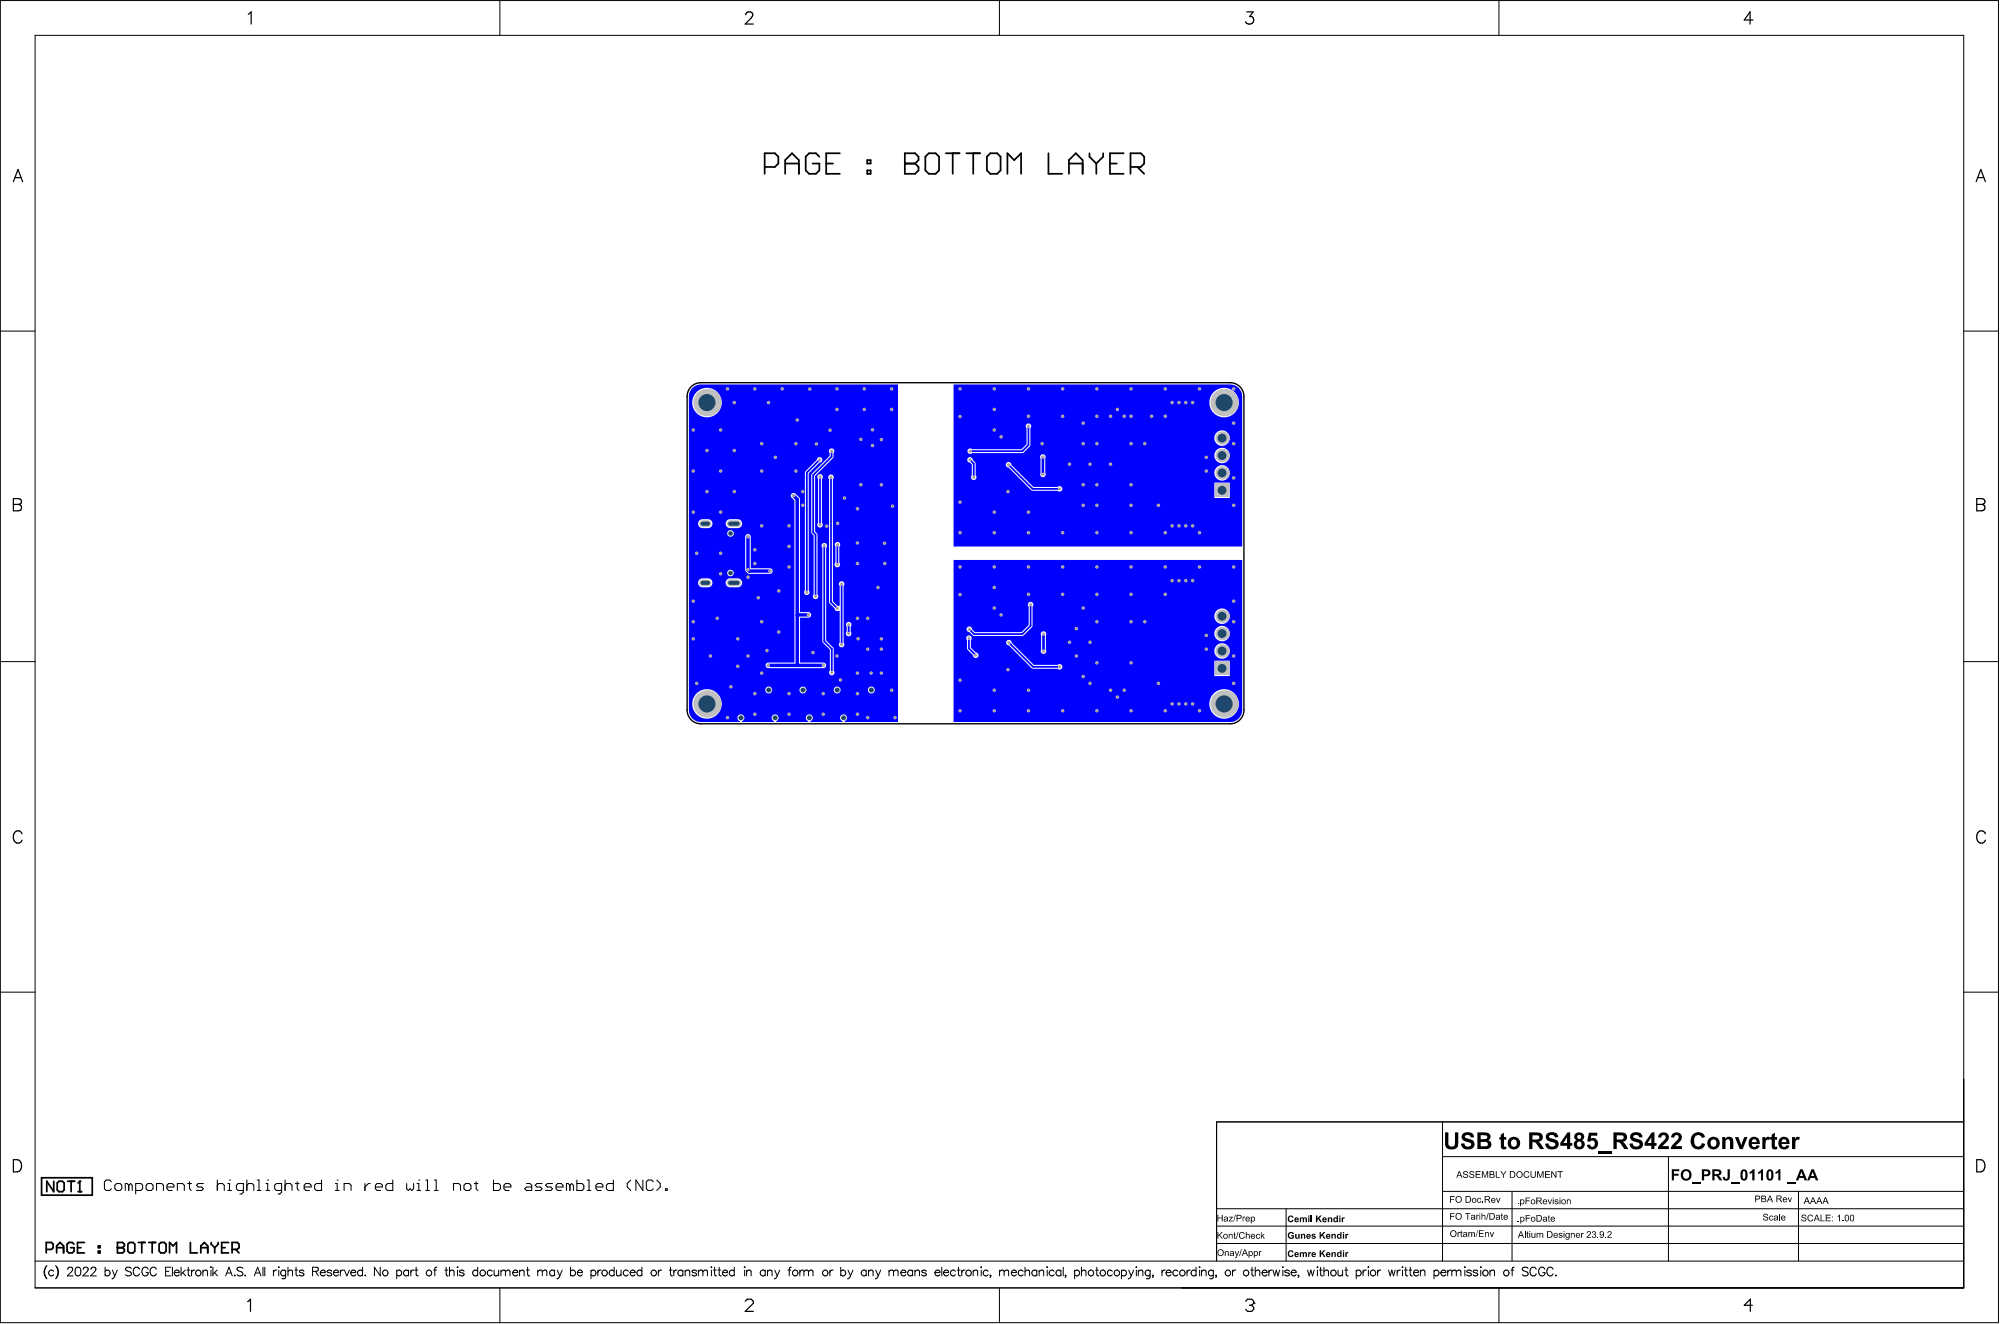
[picture p37: page 5]

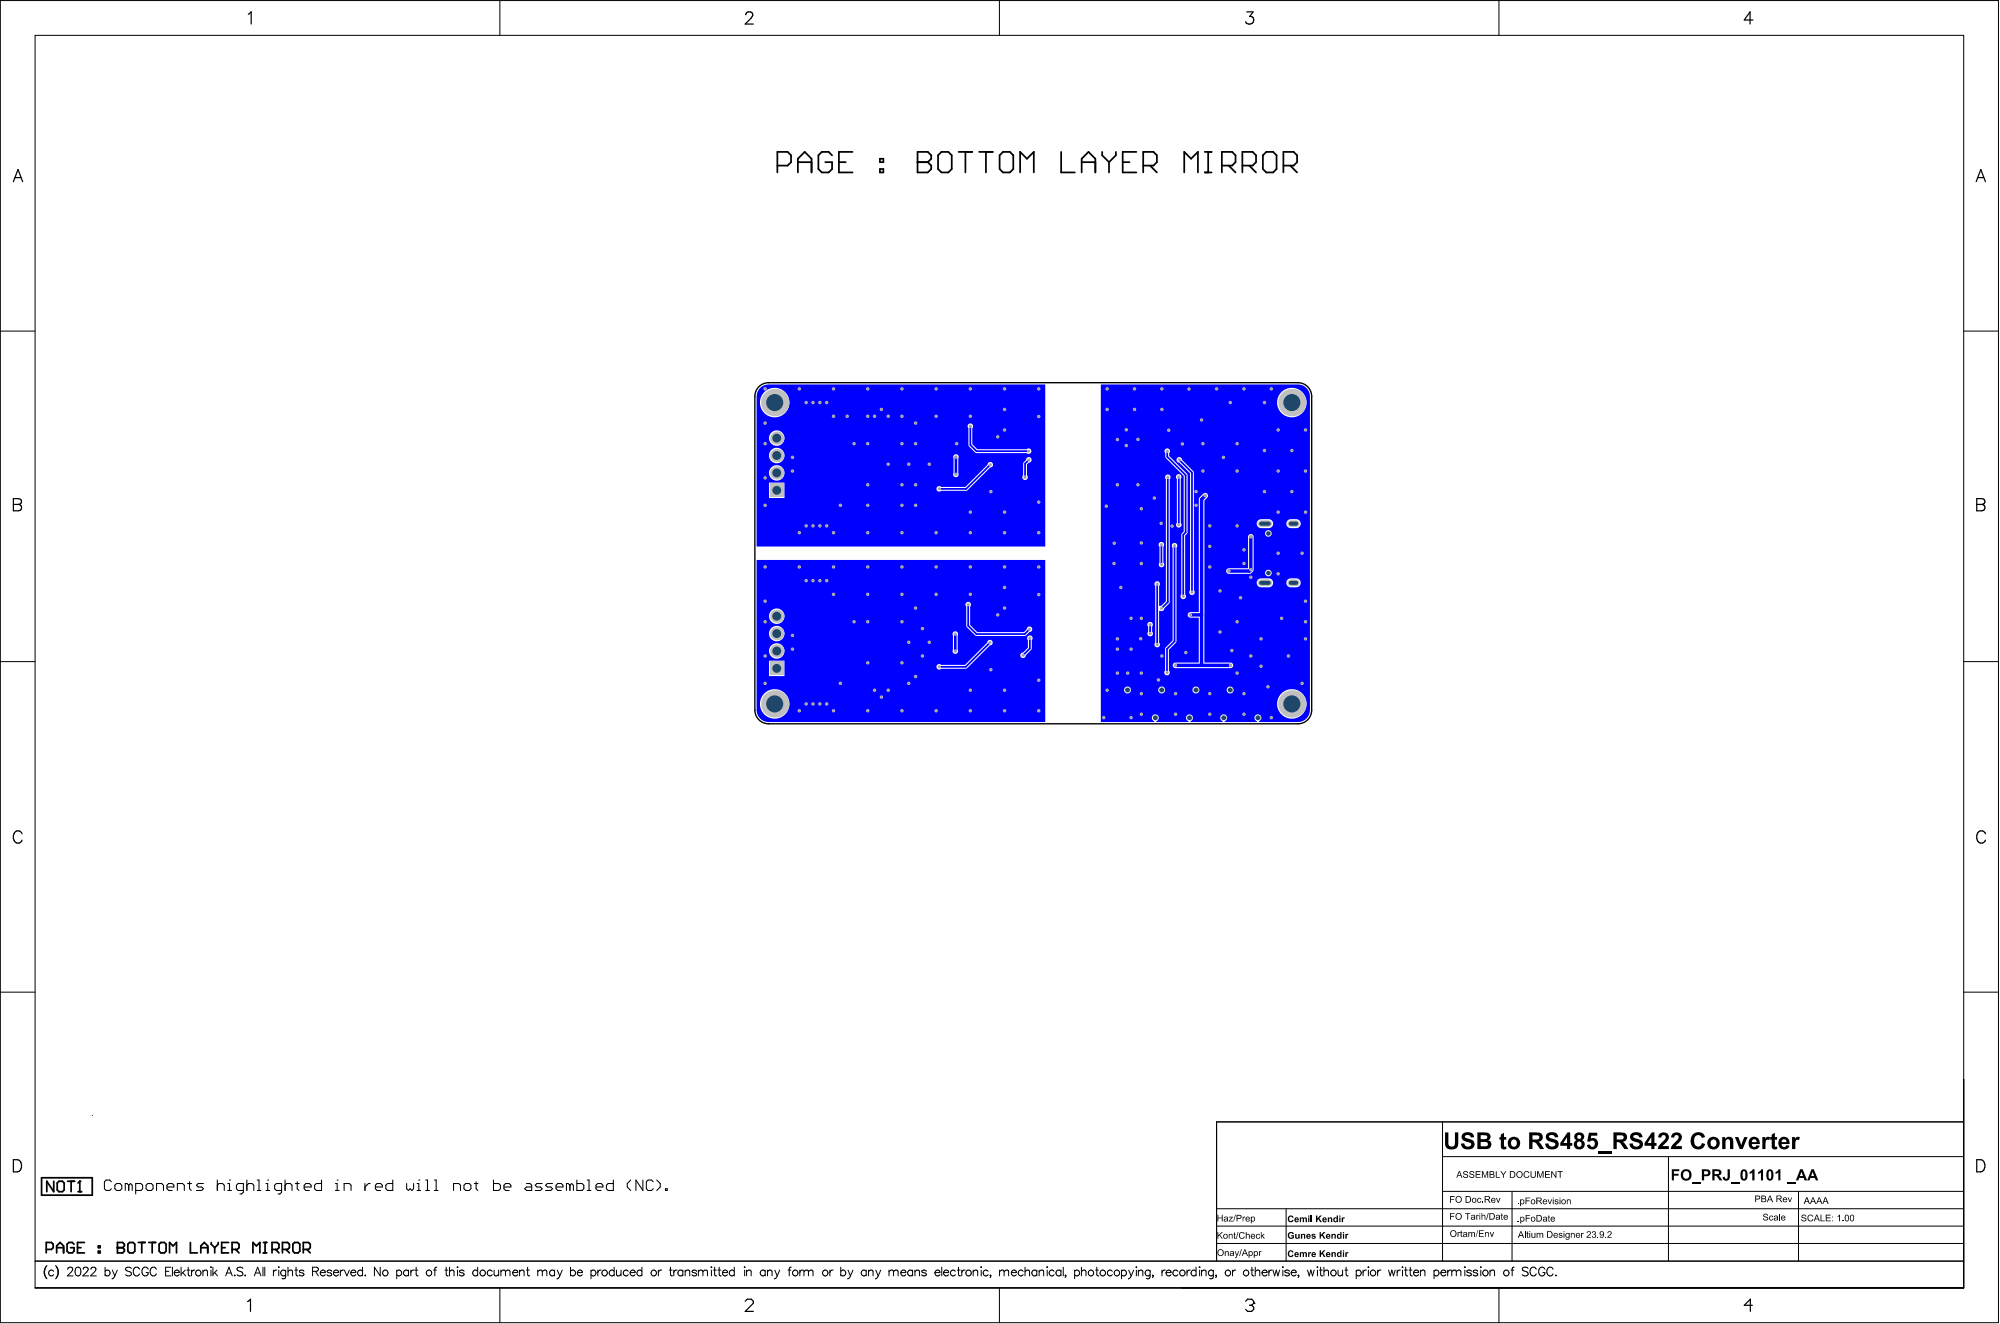
[picture p38: page 6]
