cemilkendir/isolated-usb-rs485-rs422-converter/A2_Hardware/PCB_0110_01_AA/out/30_Assembly/FO_PRJ_01101_01_AAAA.PDF

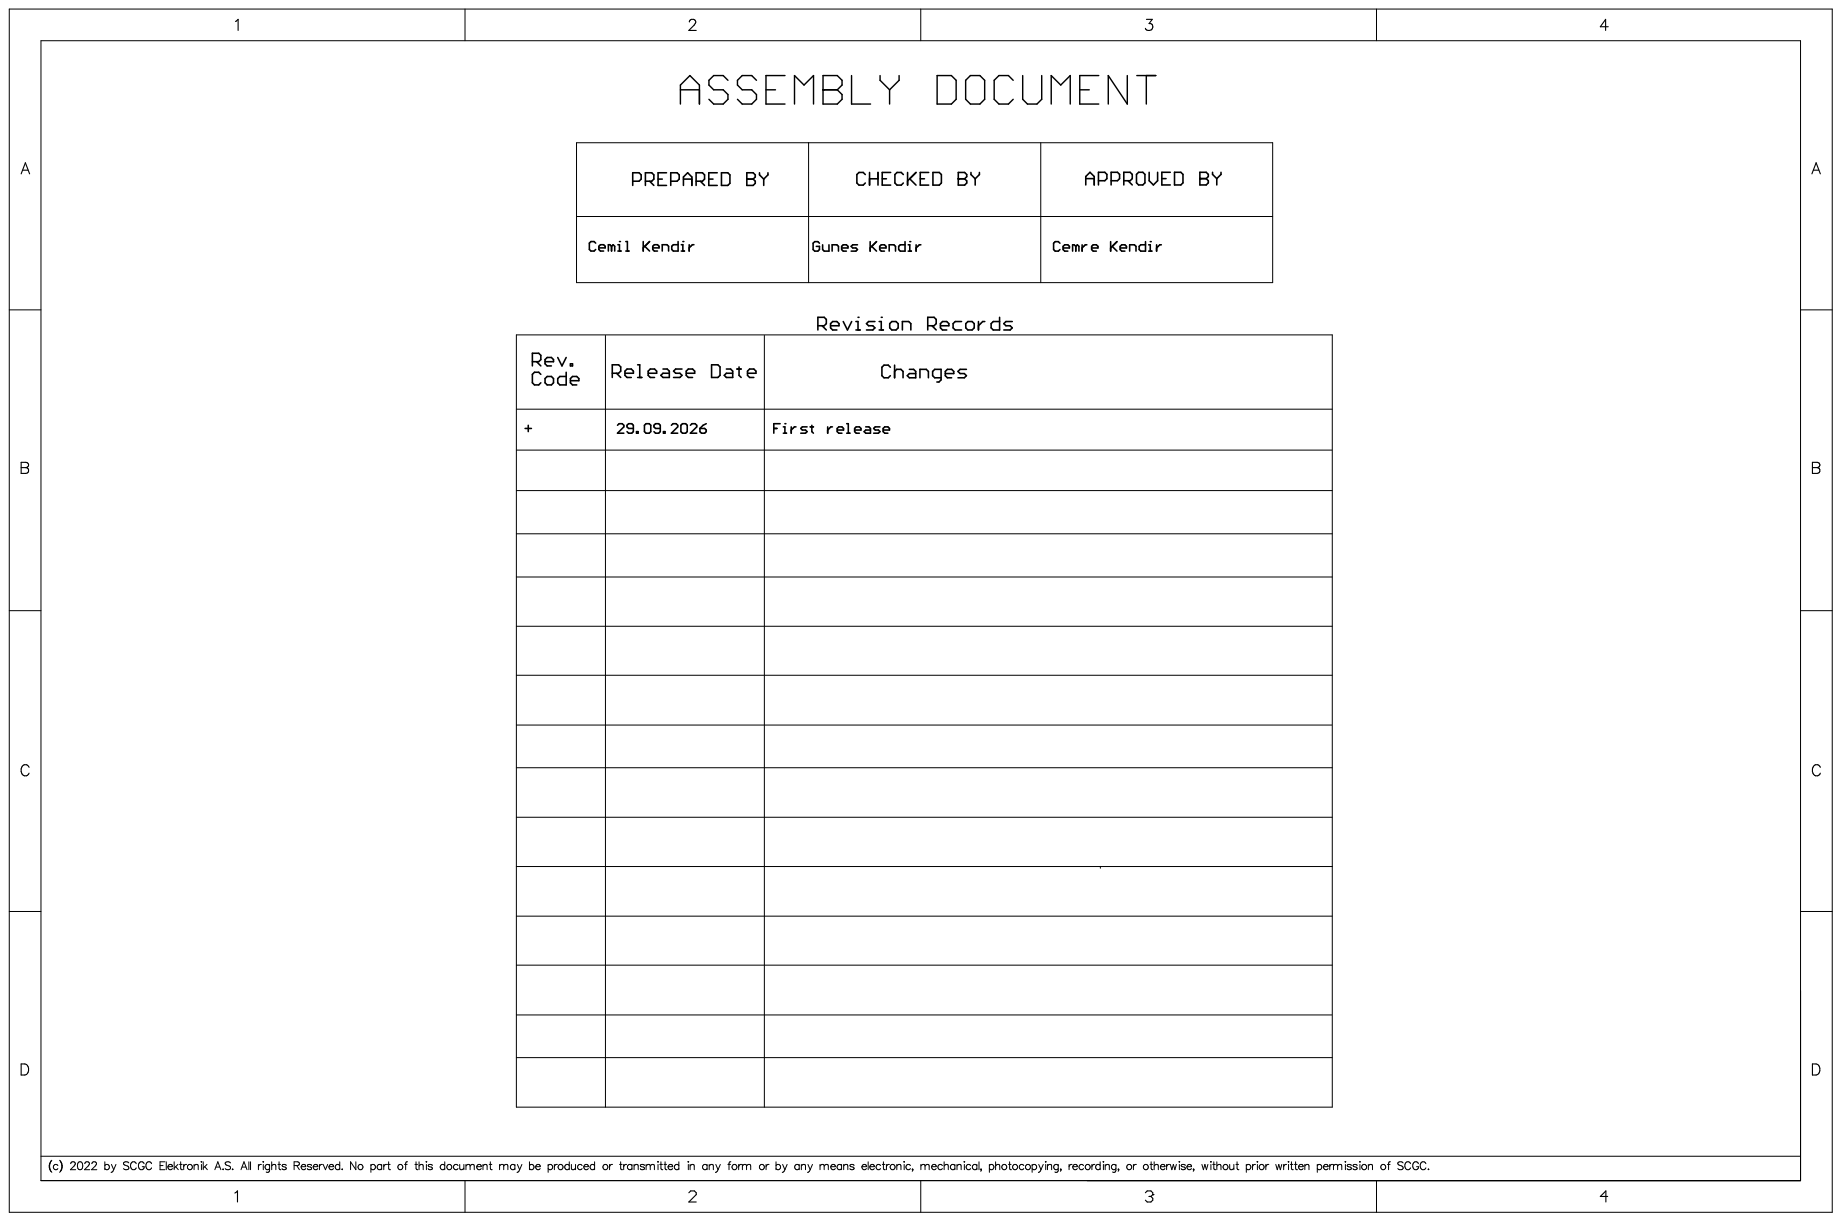
[picture p39: page 1]

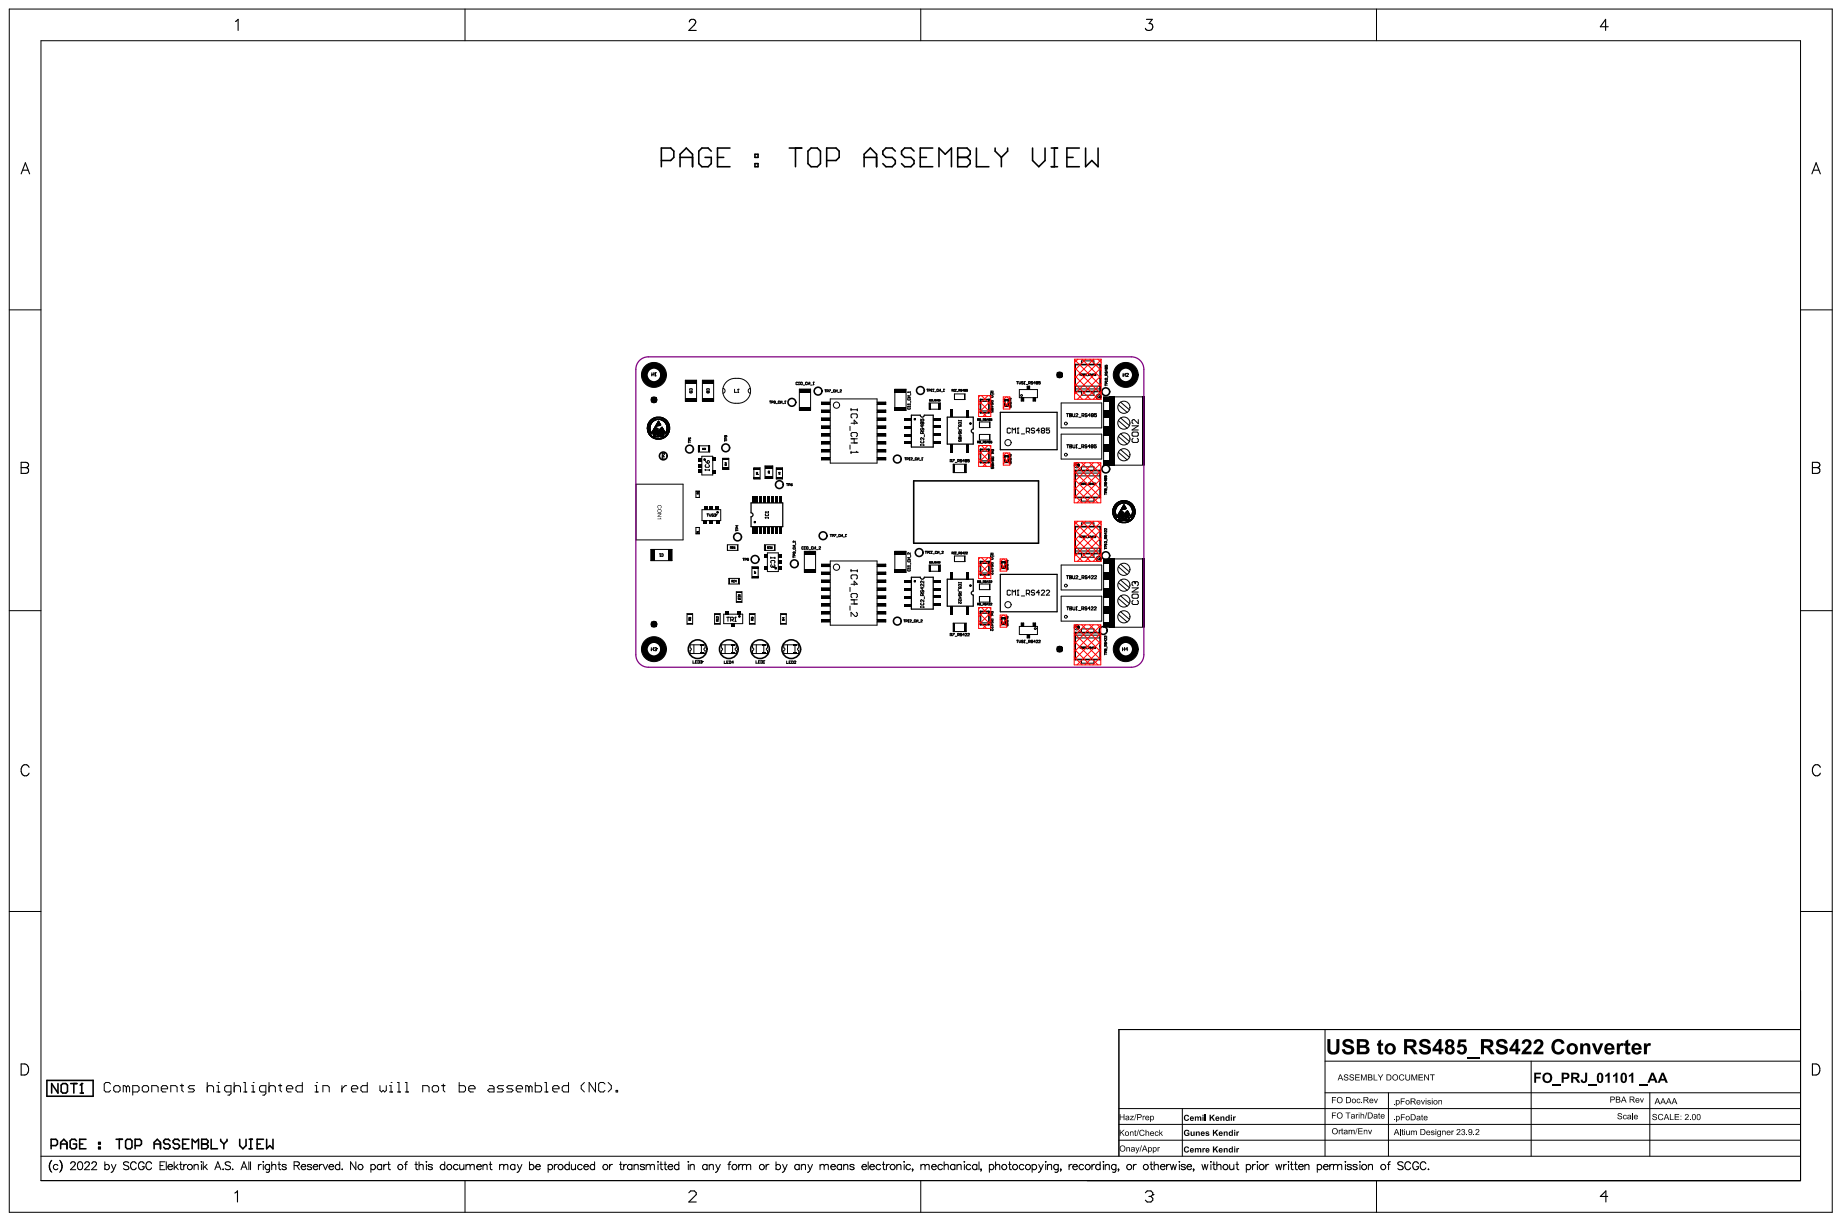
[picture p40: page 2]

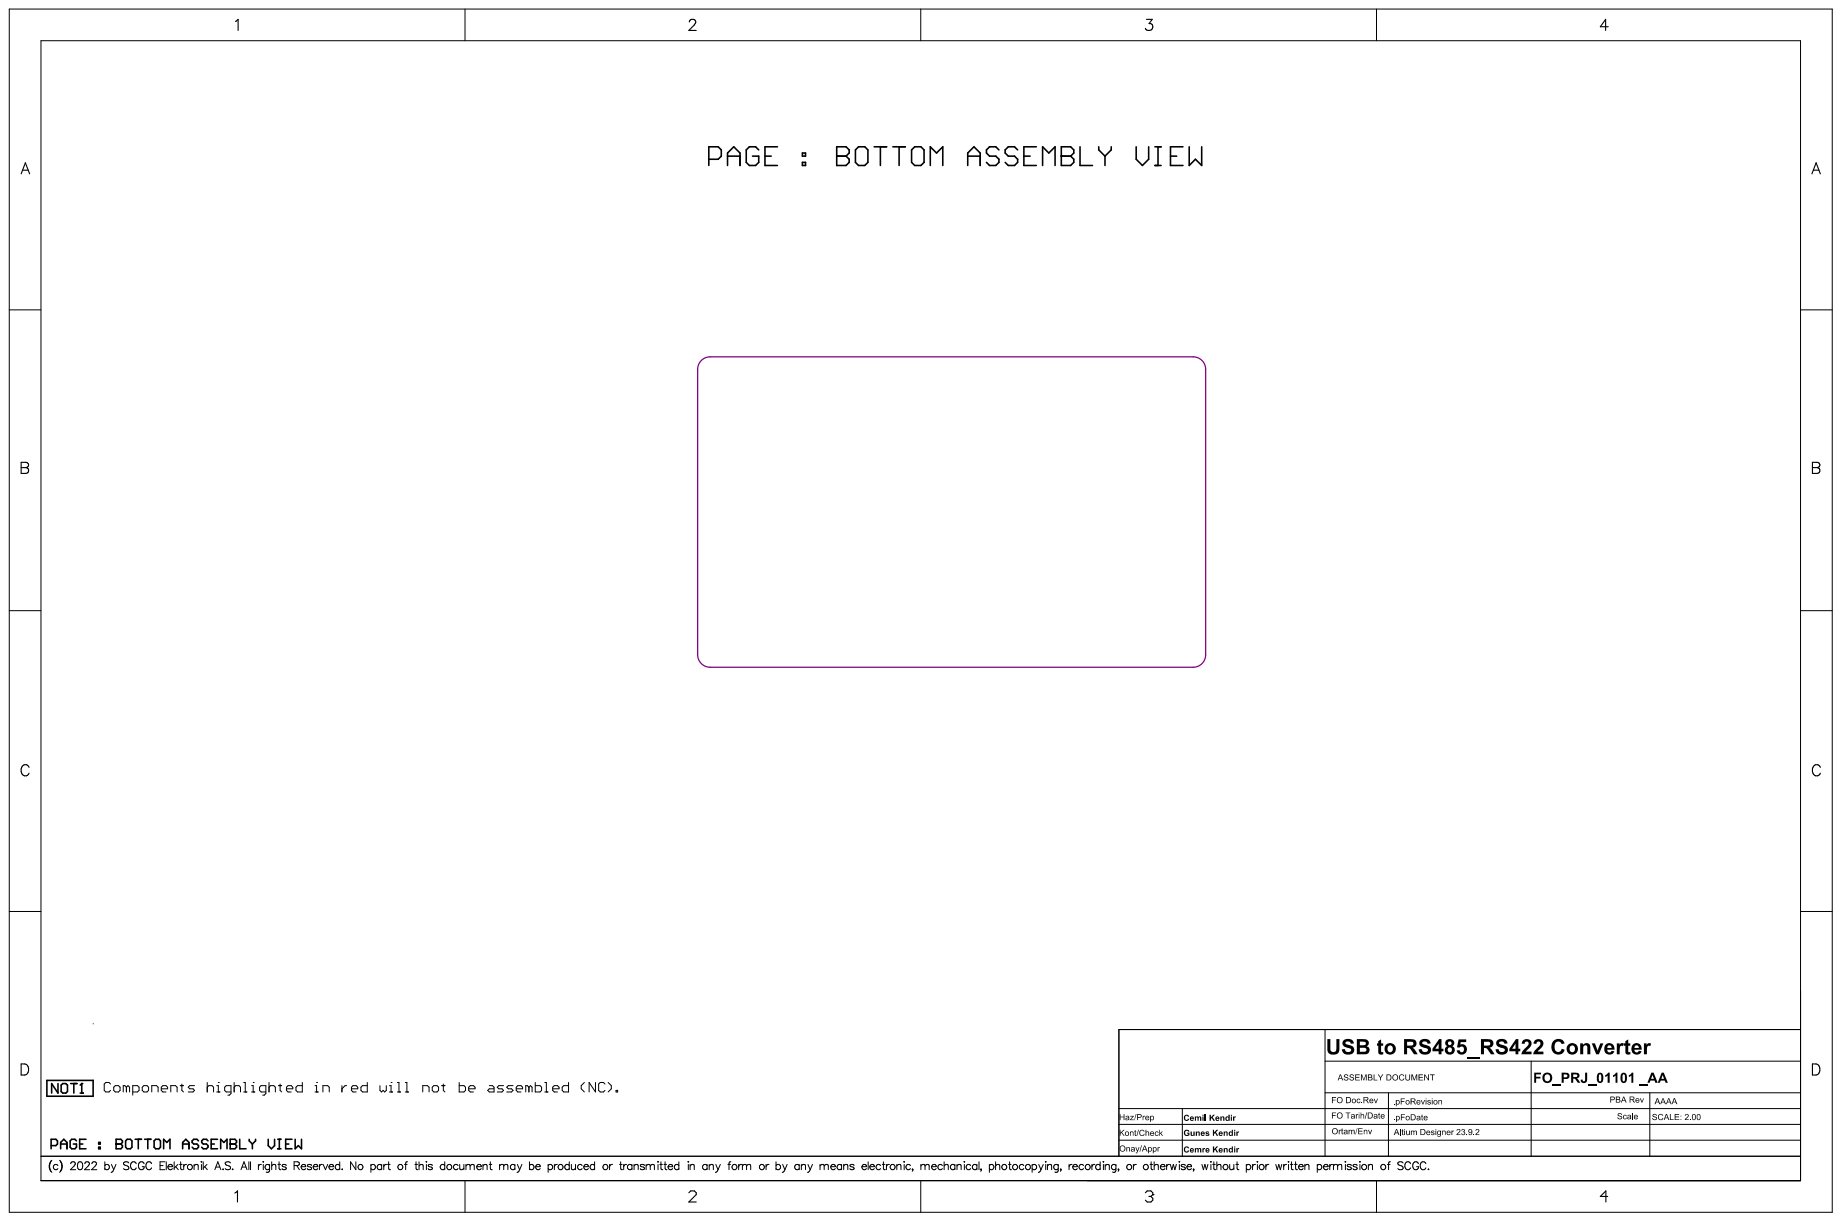
[picture p41: page 3]

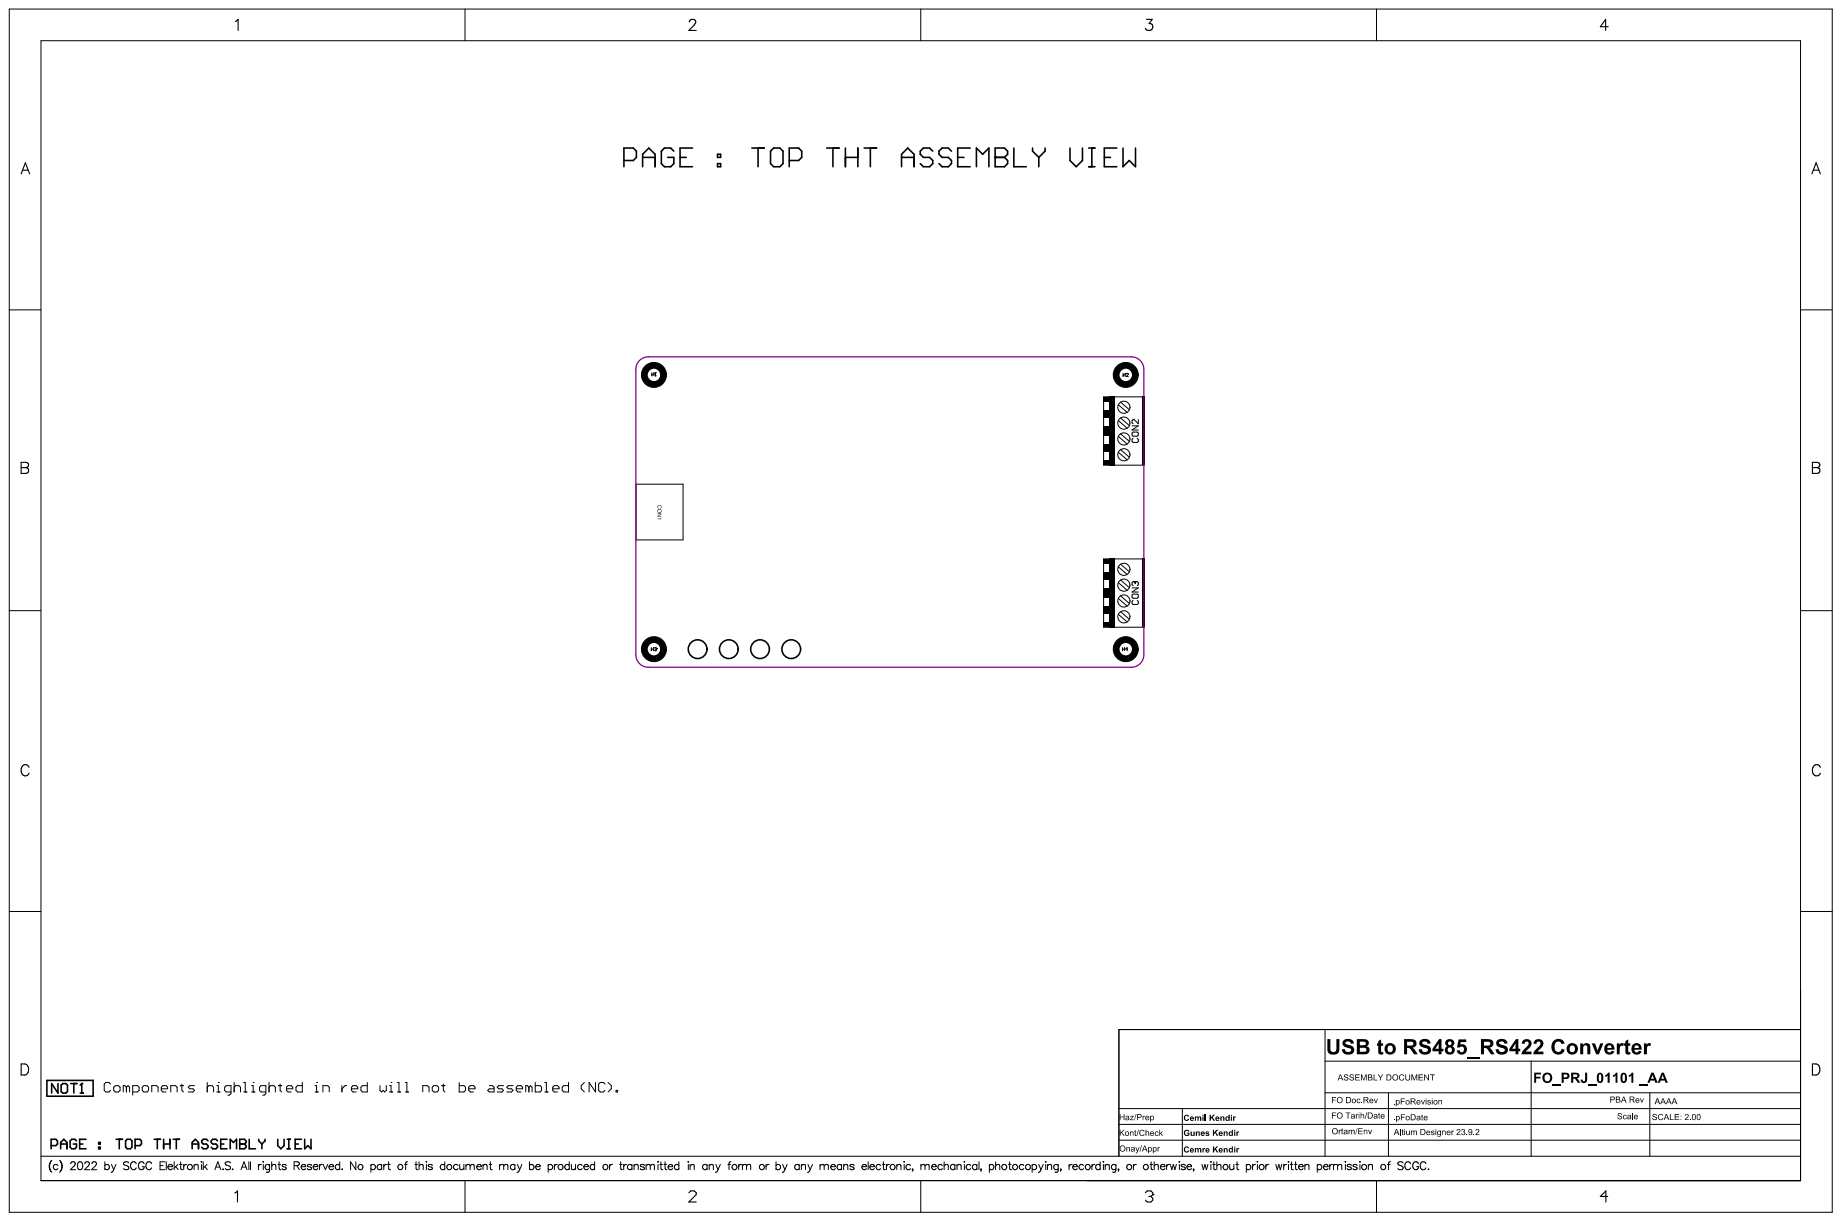
[picture p42: page 4]

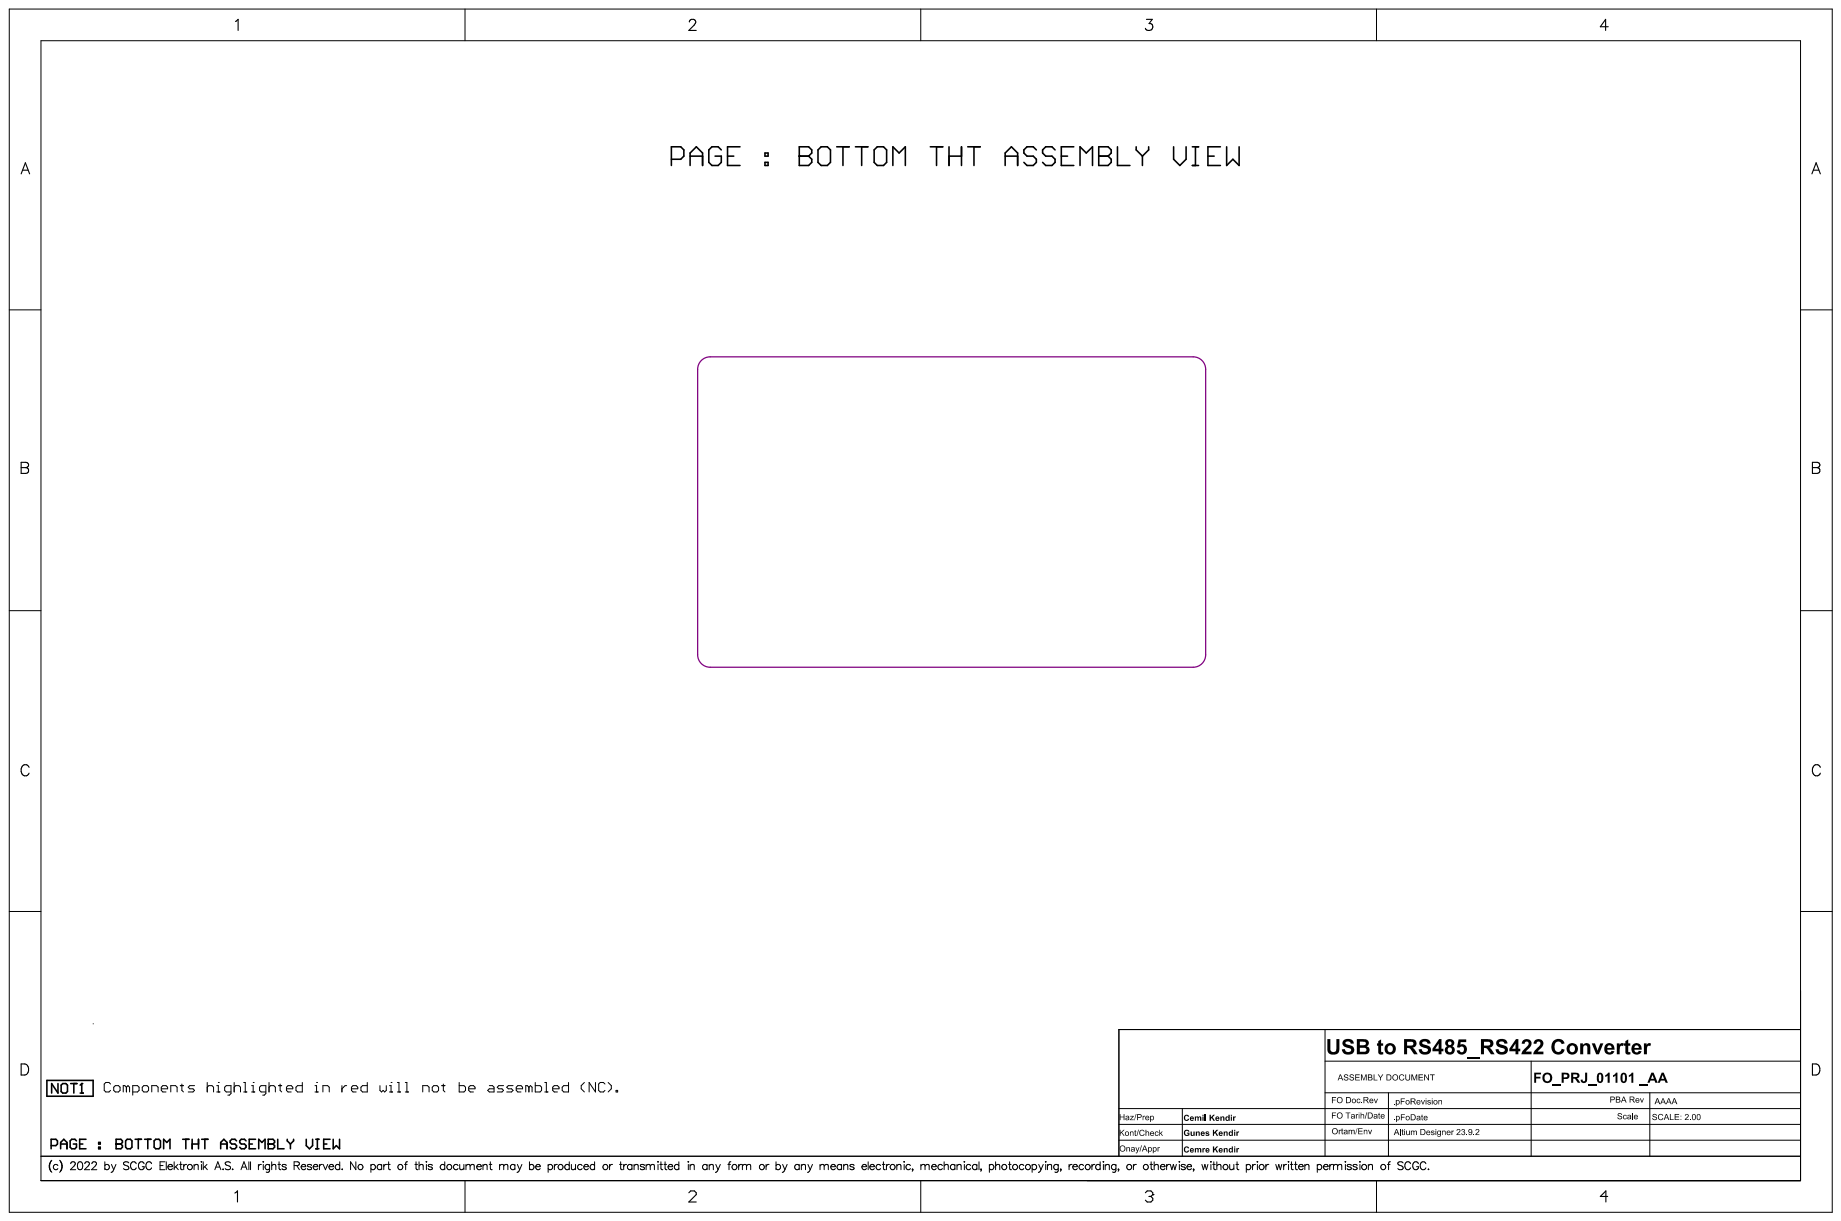
[picture p43: page 5]

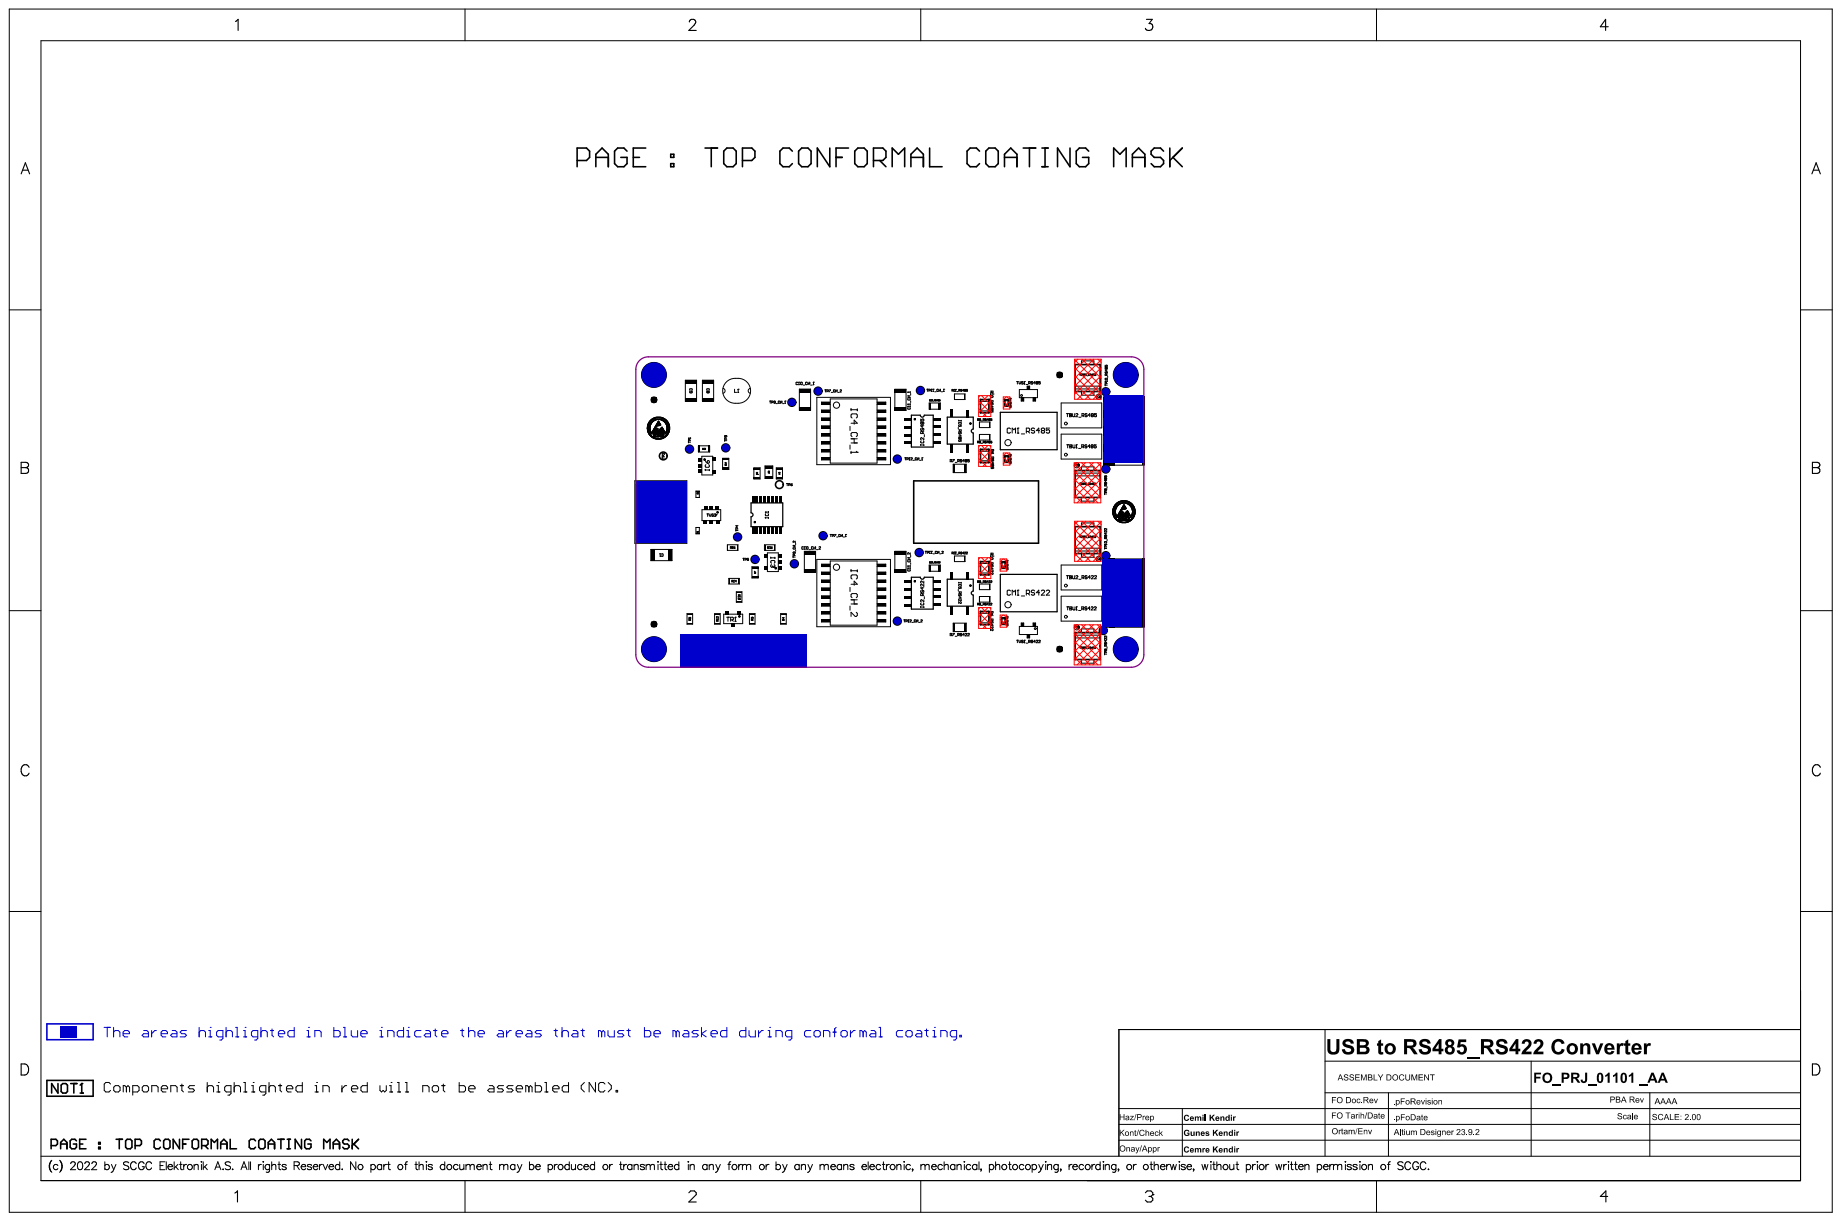
[picture p44: page 6]

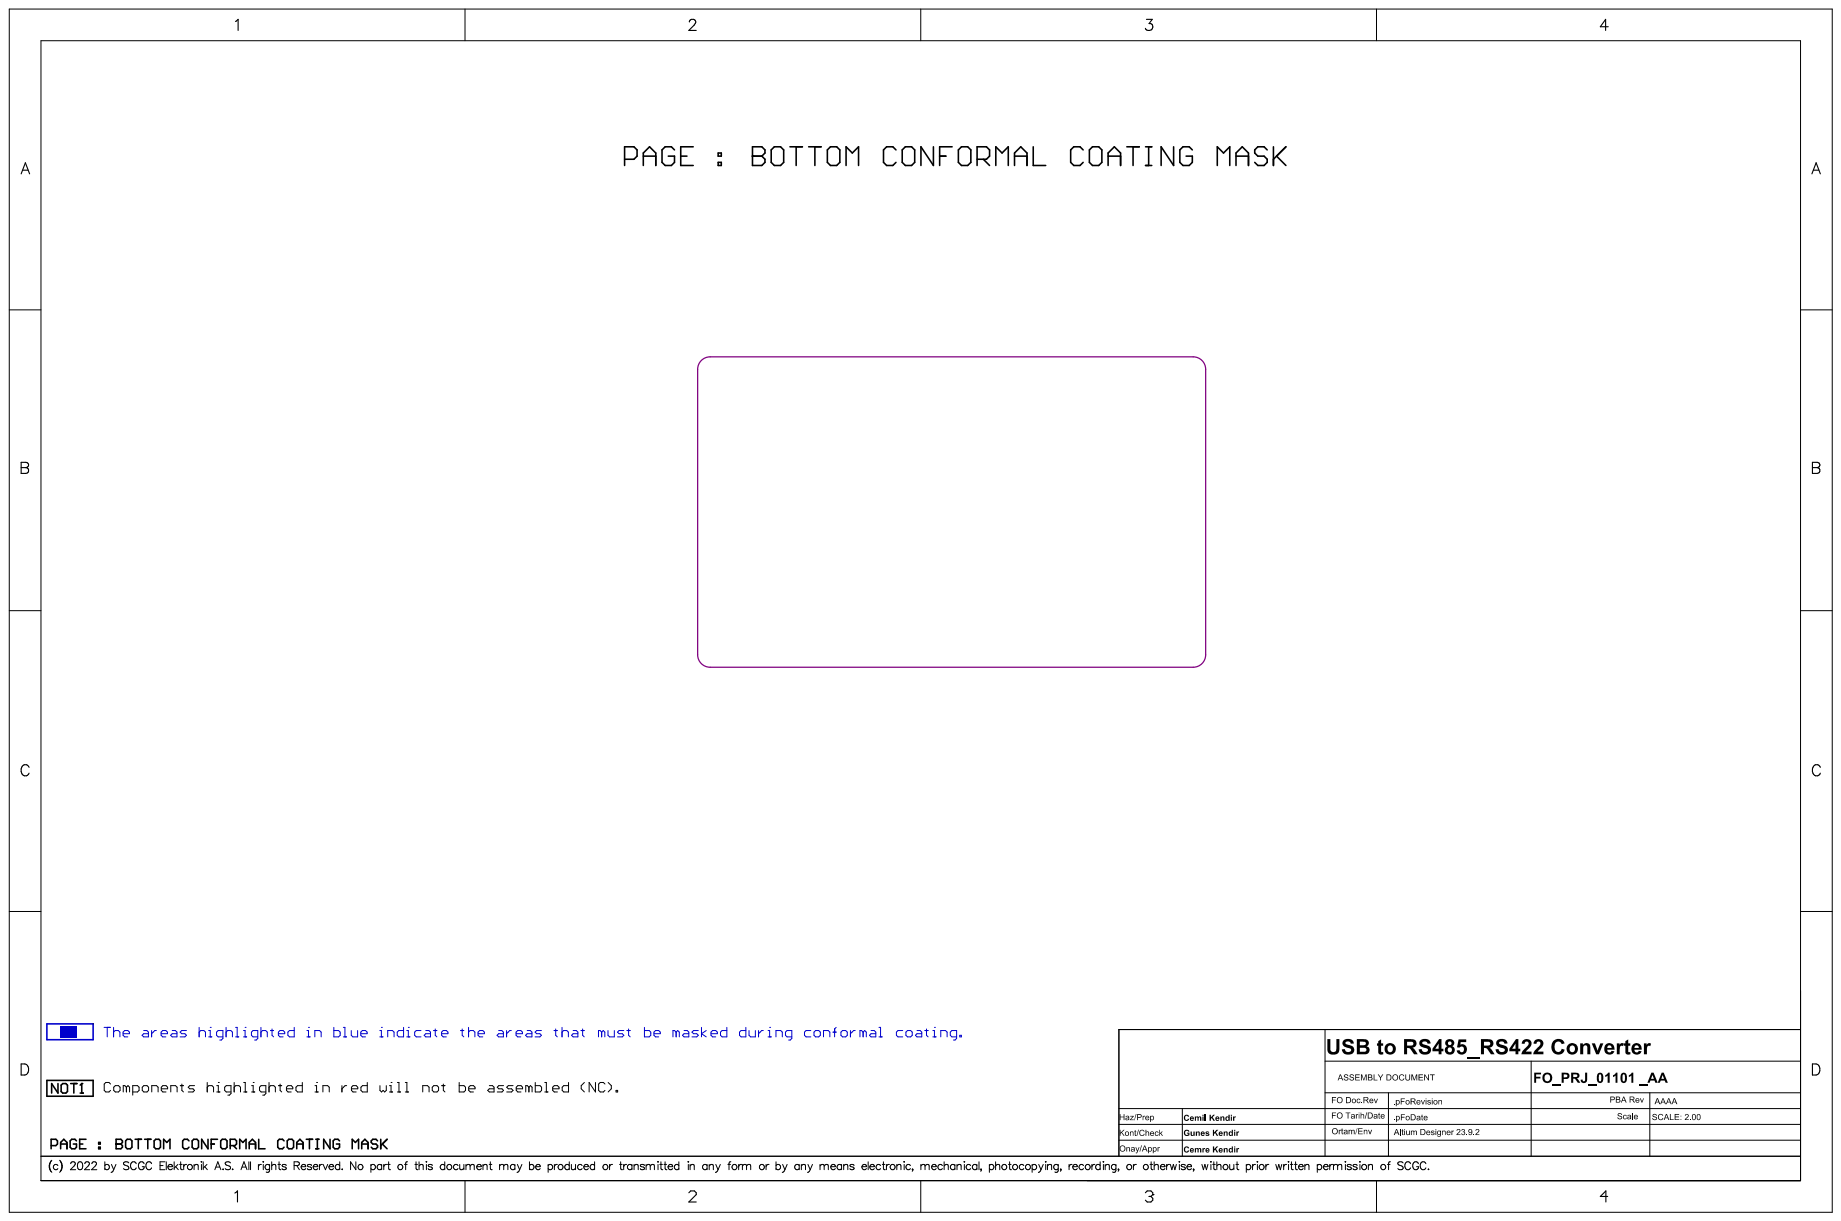
[picture p45: page 7]

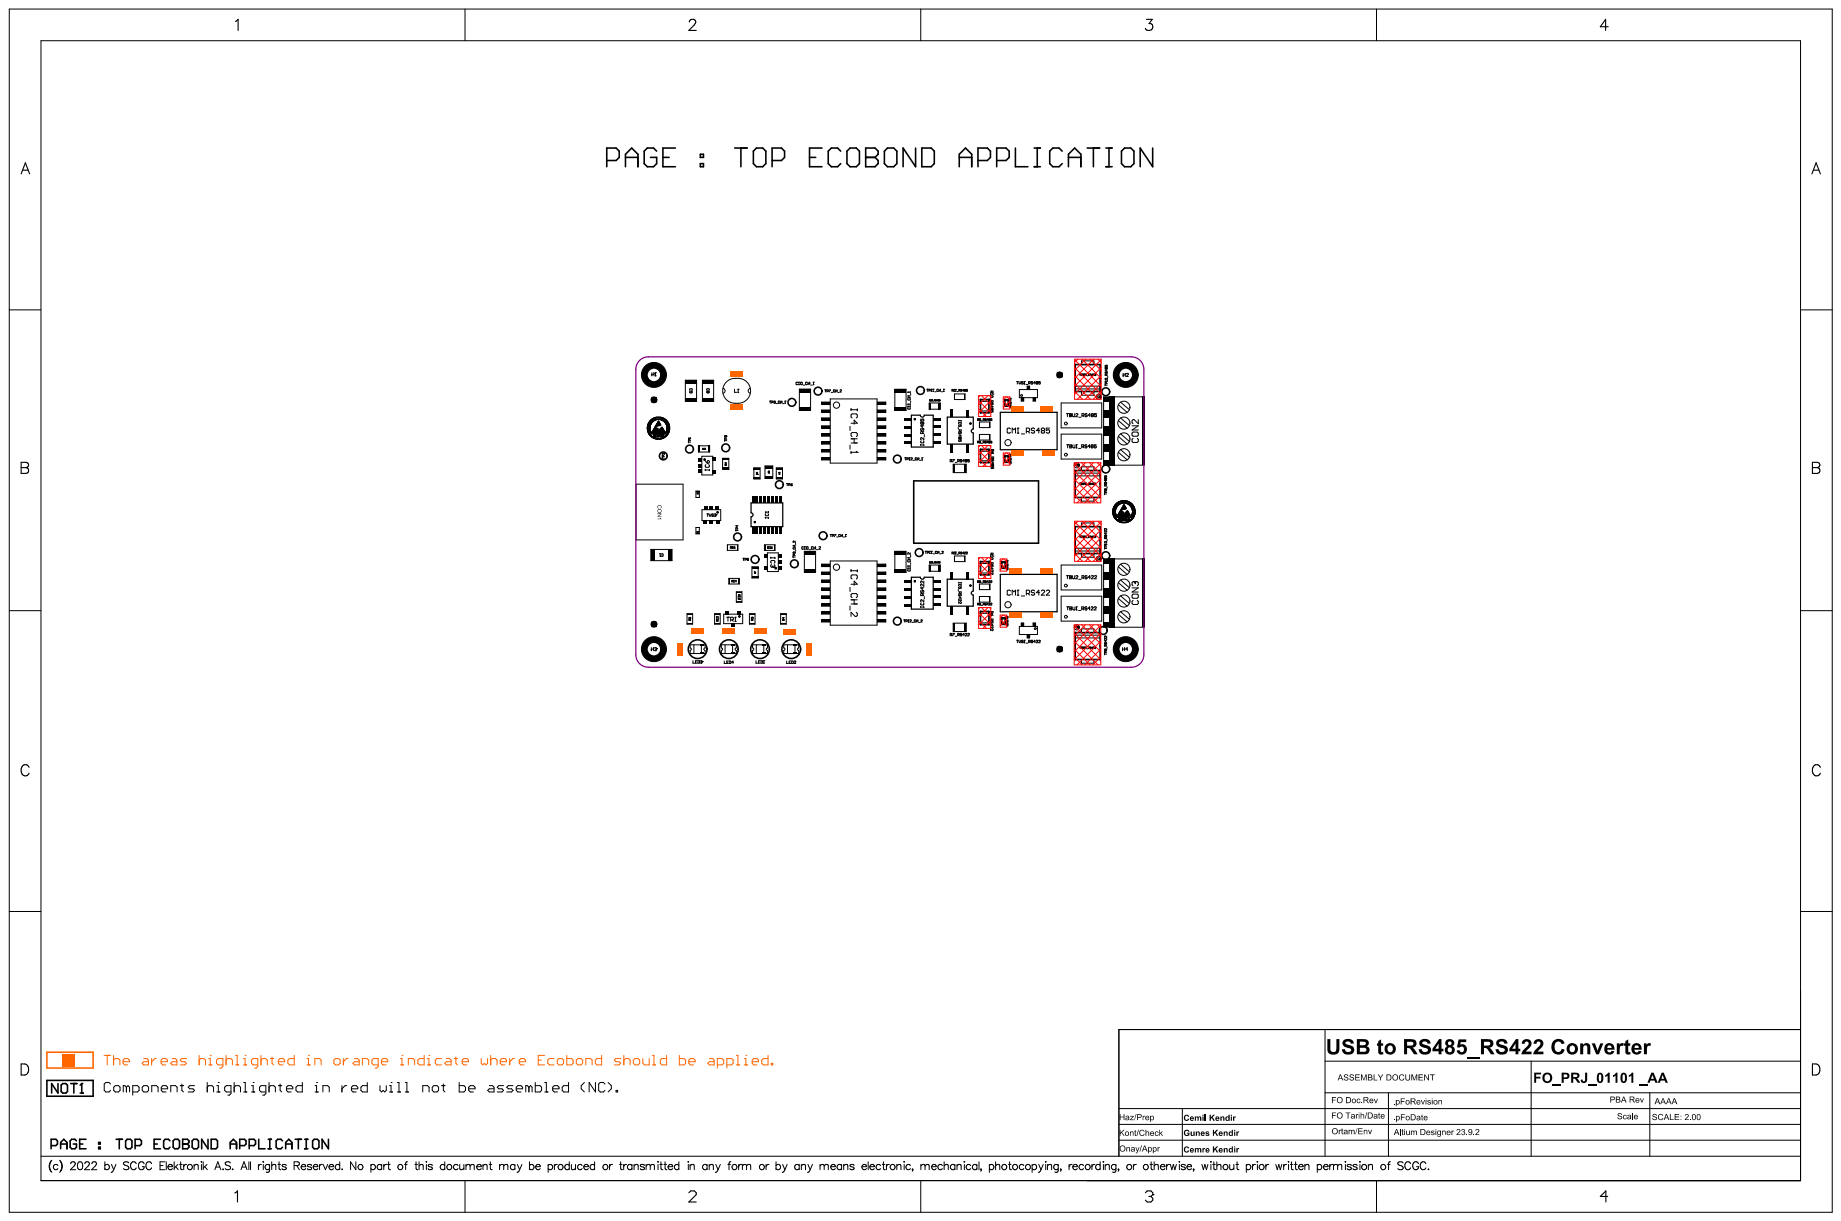
[picture p46: page 8]

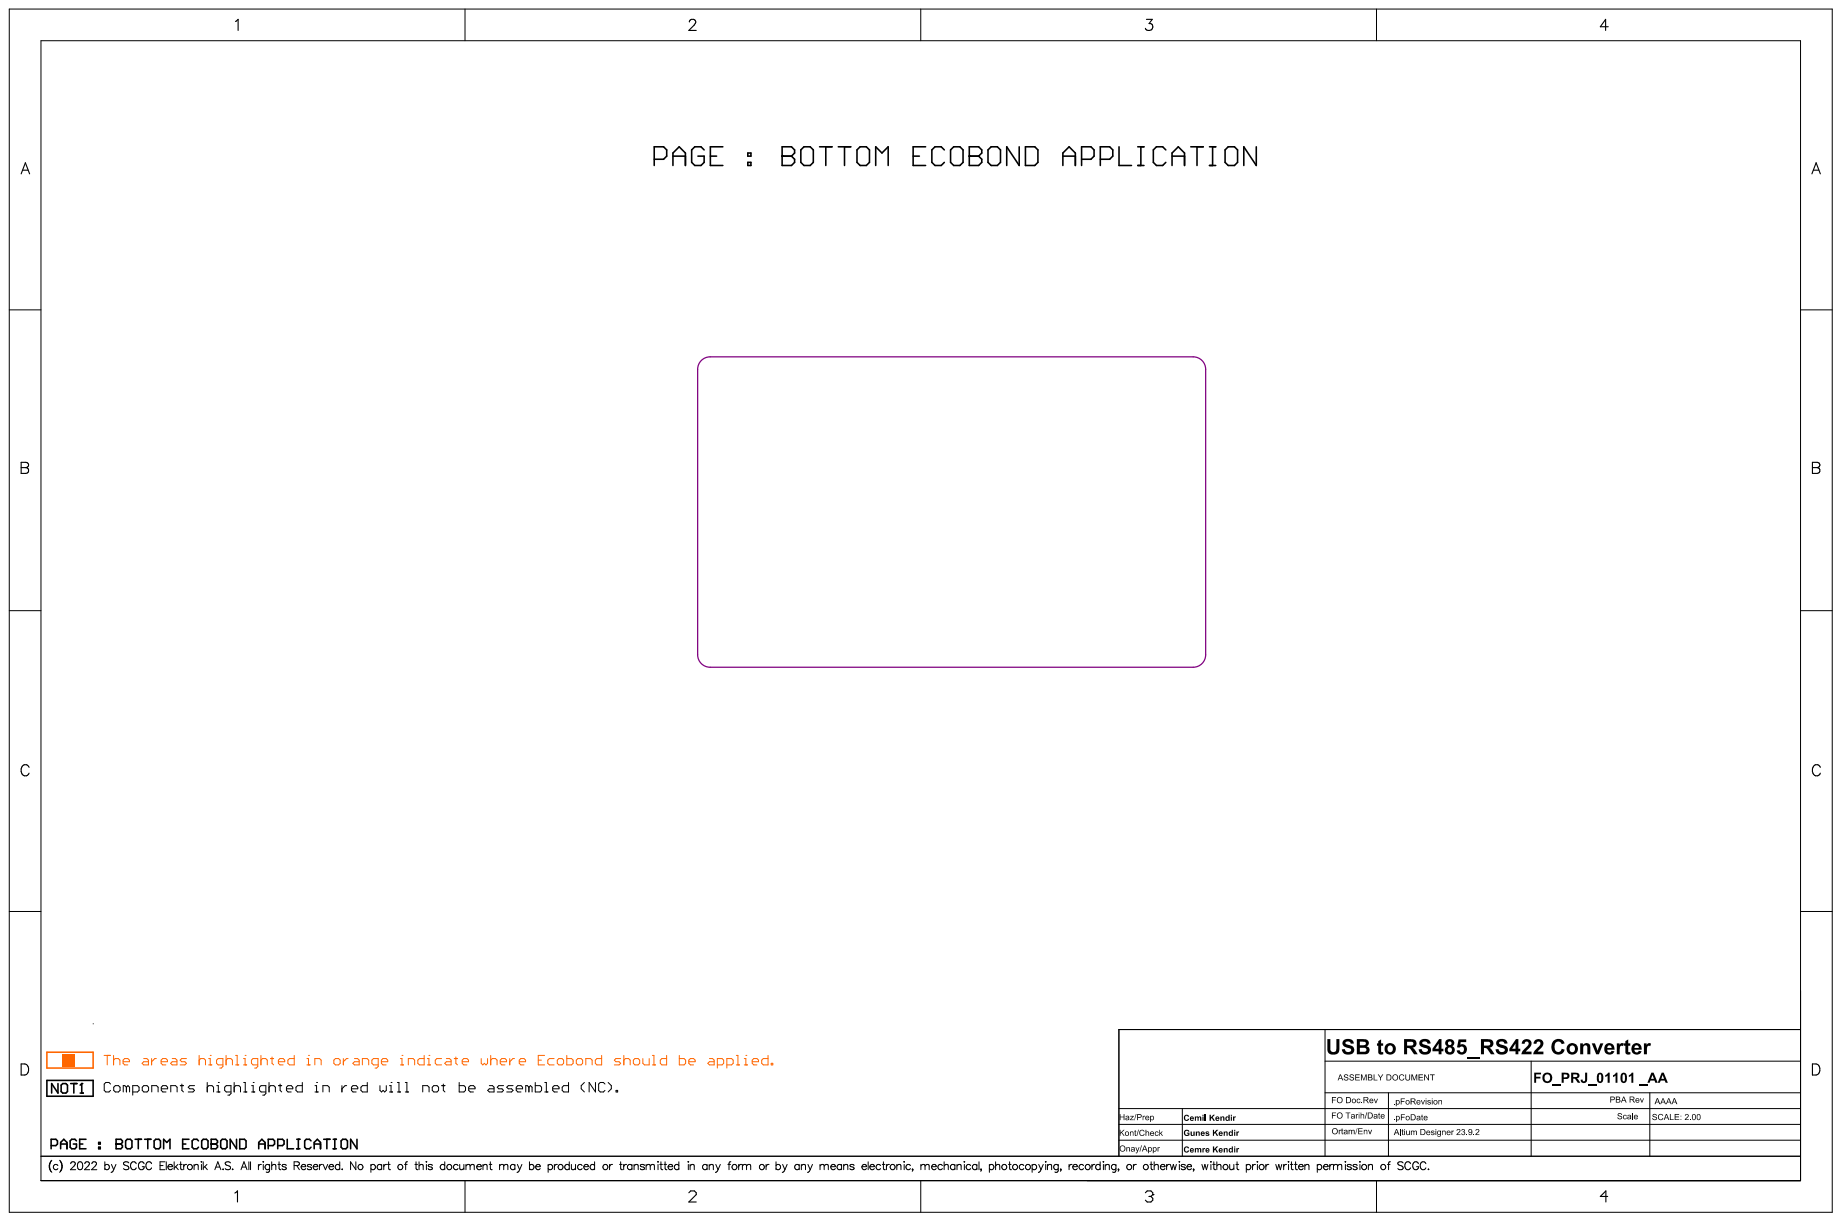
[picture p47: page 9]

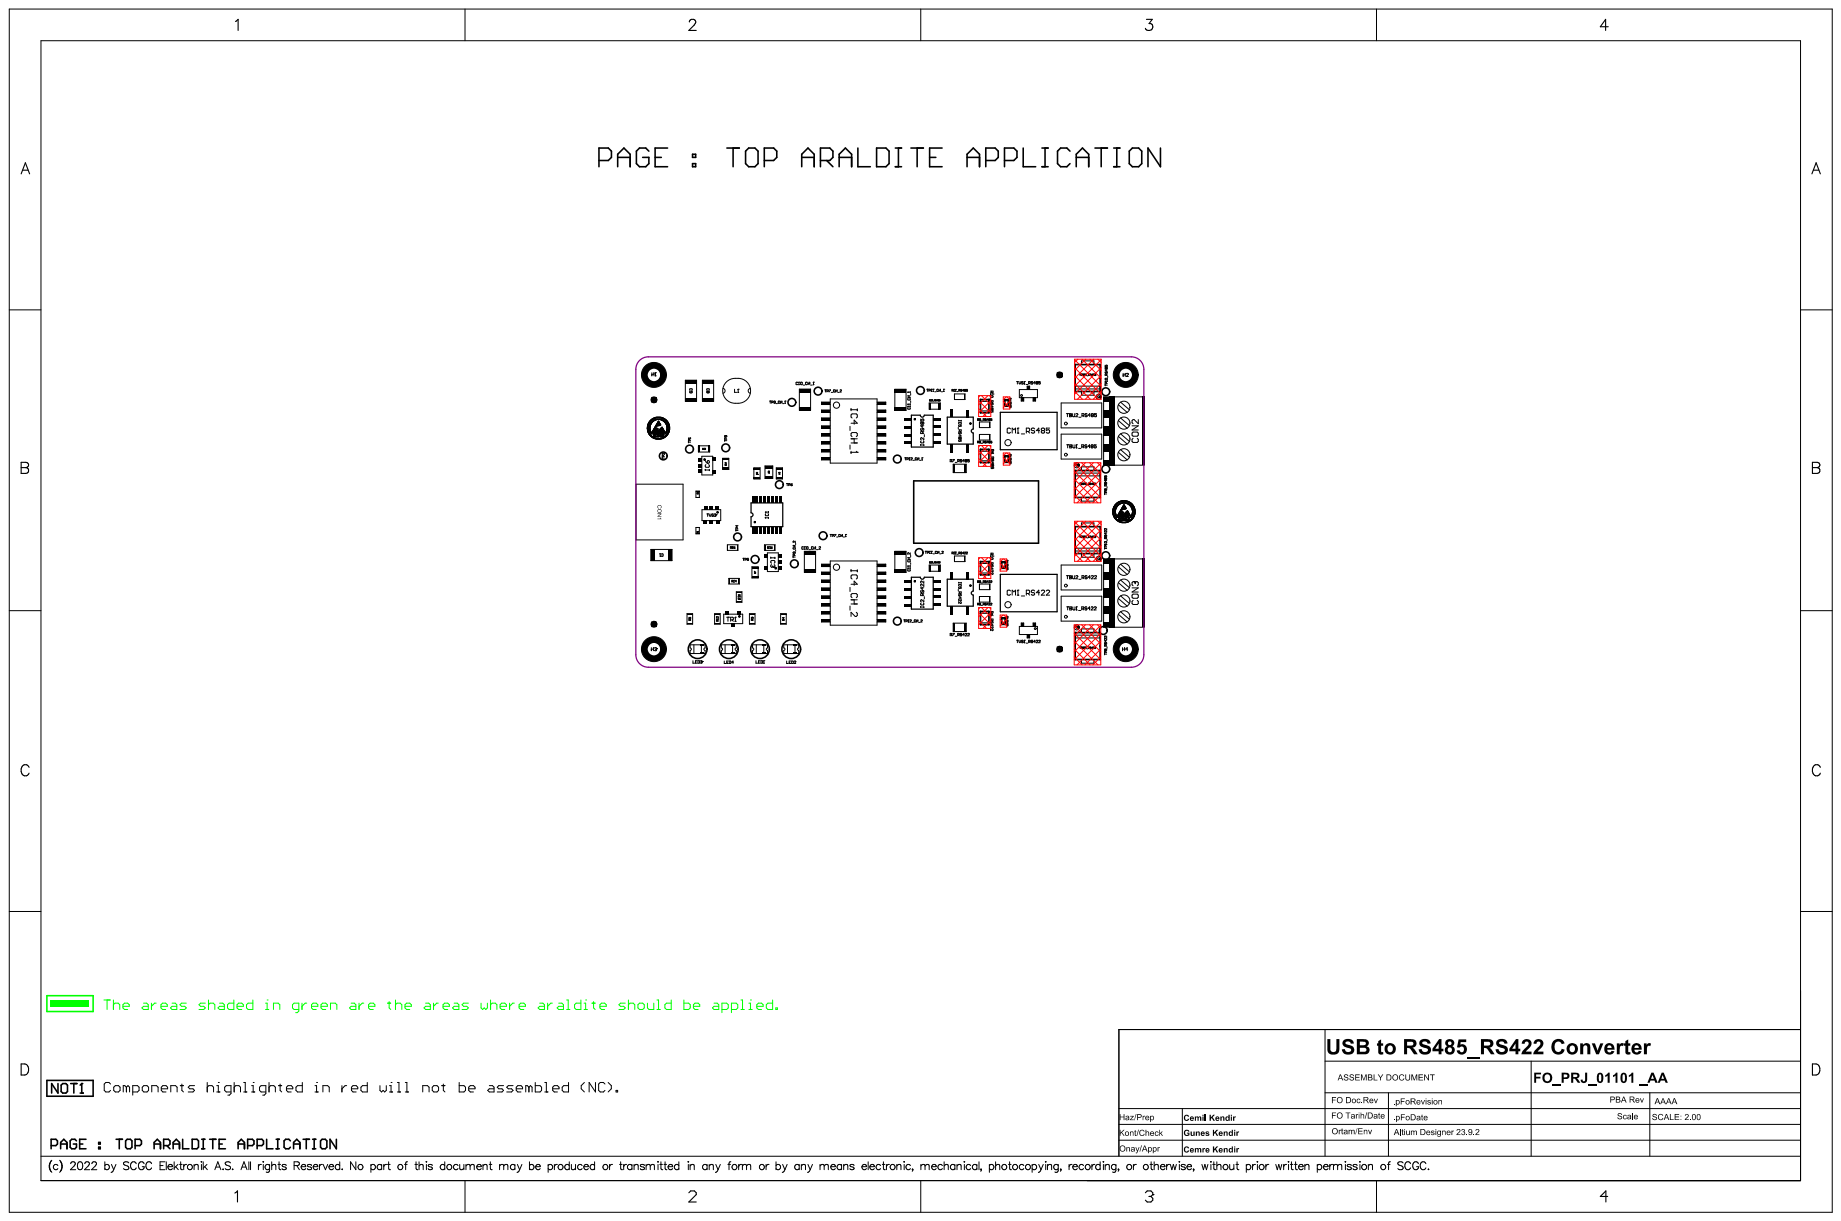
[picture p48: page 10]

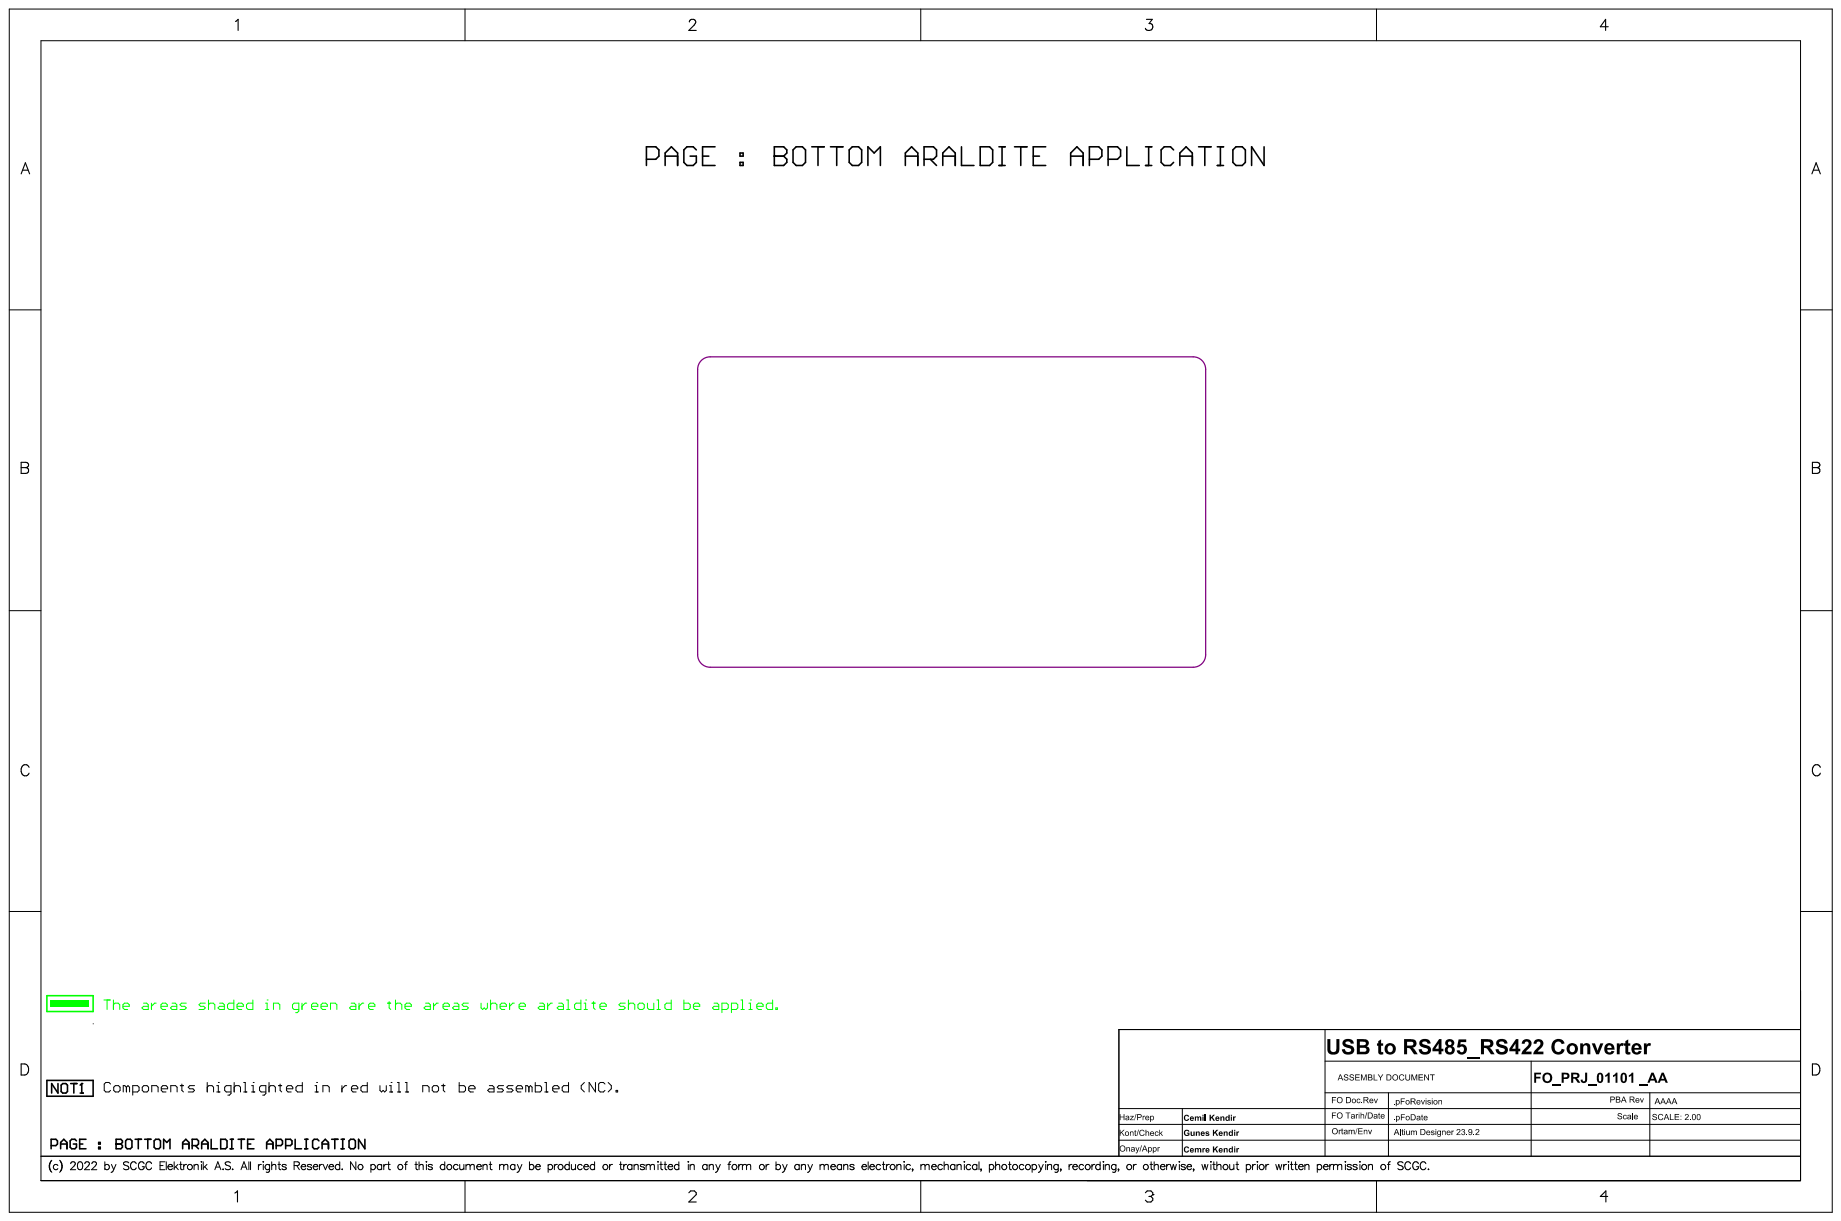
[picture p49: page 11]

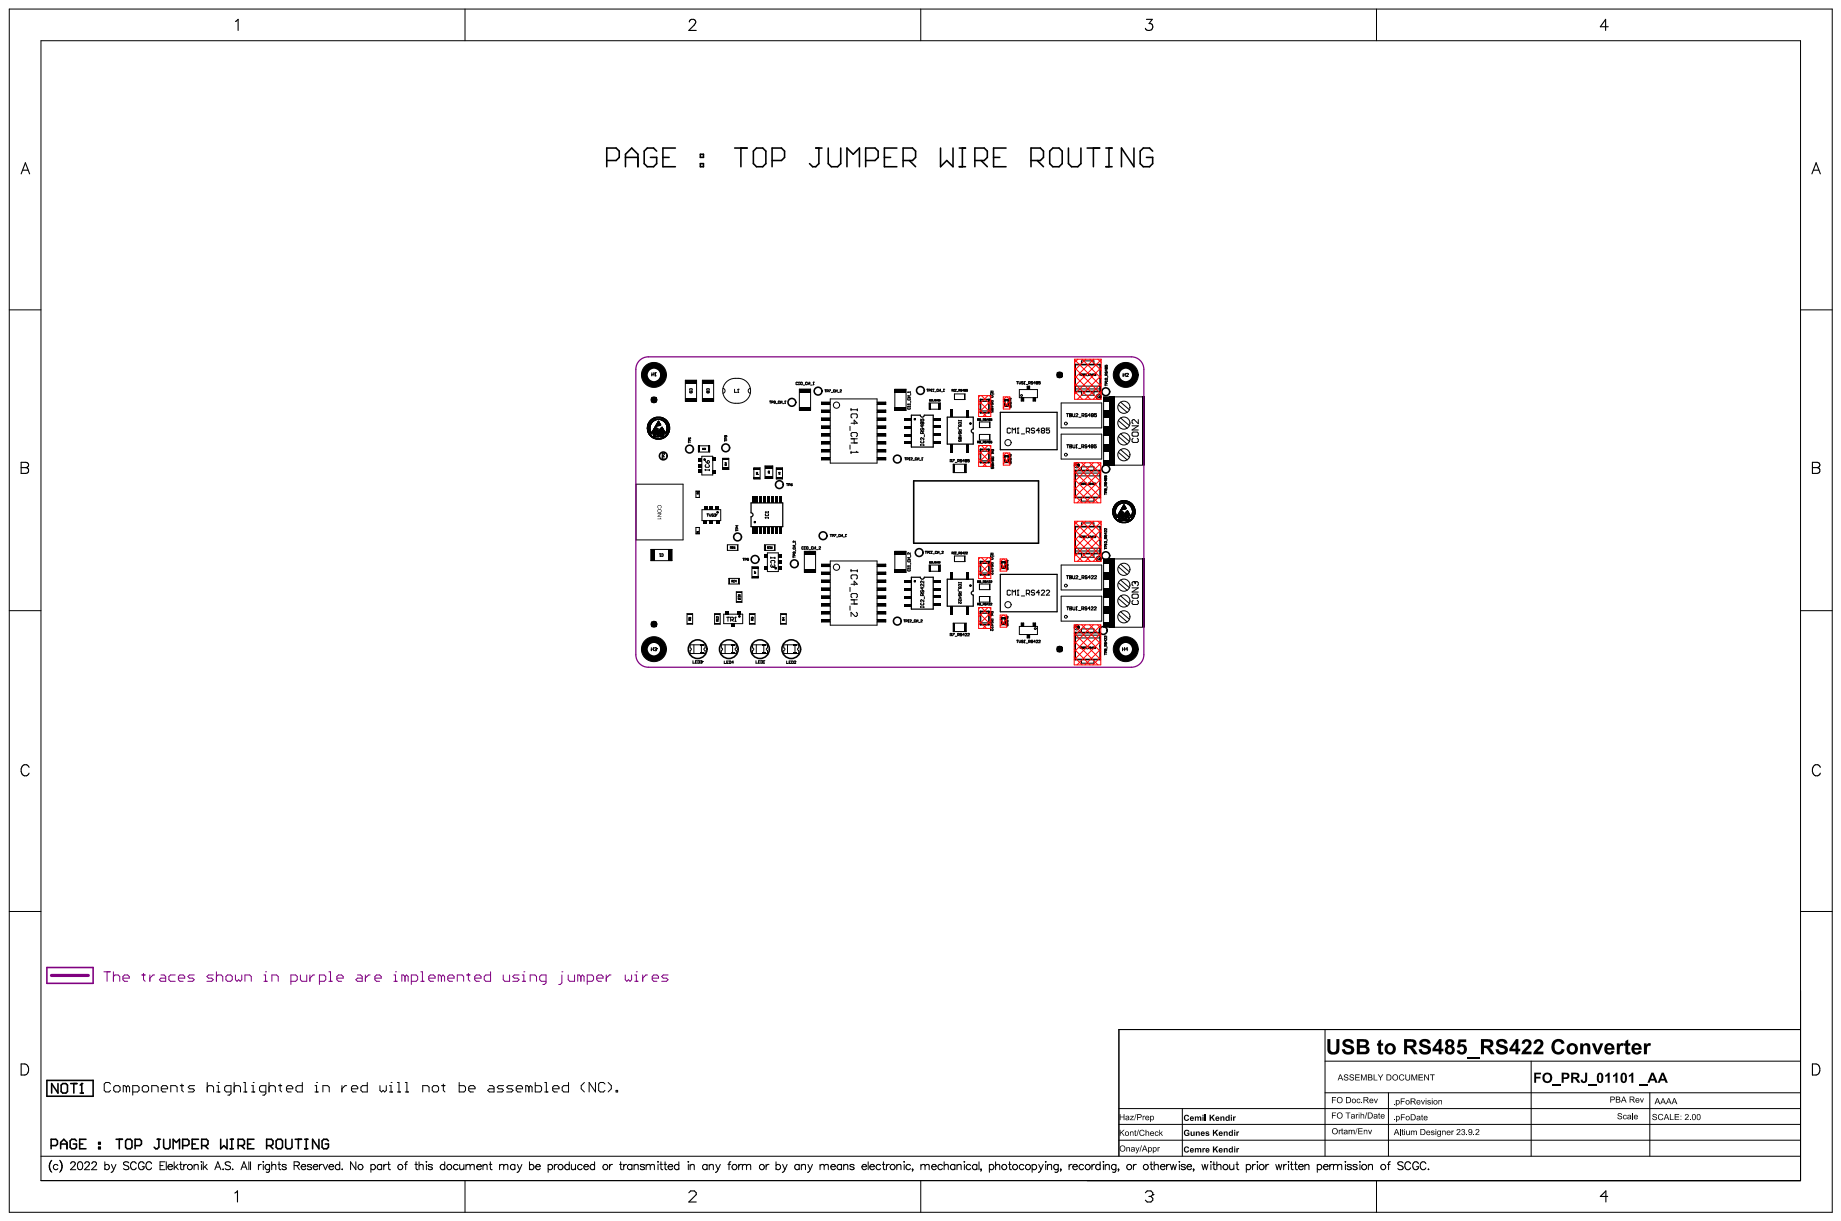
[picture p50: page 12]

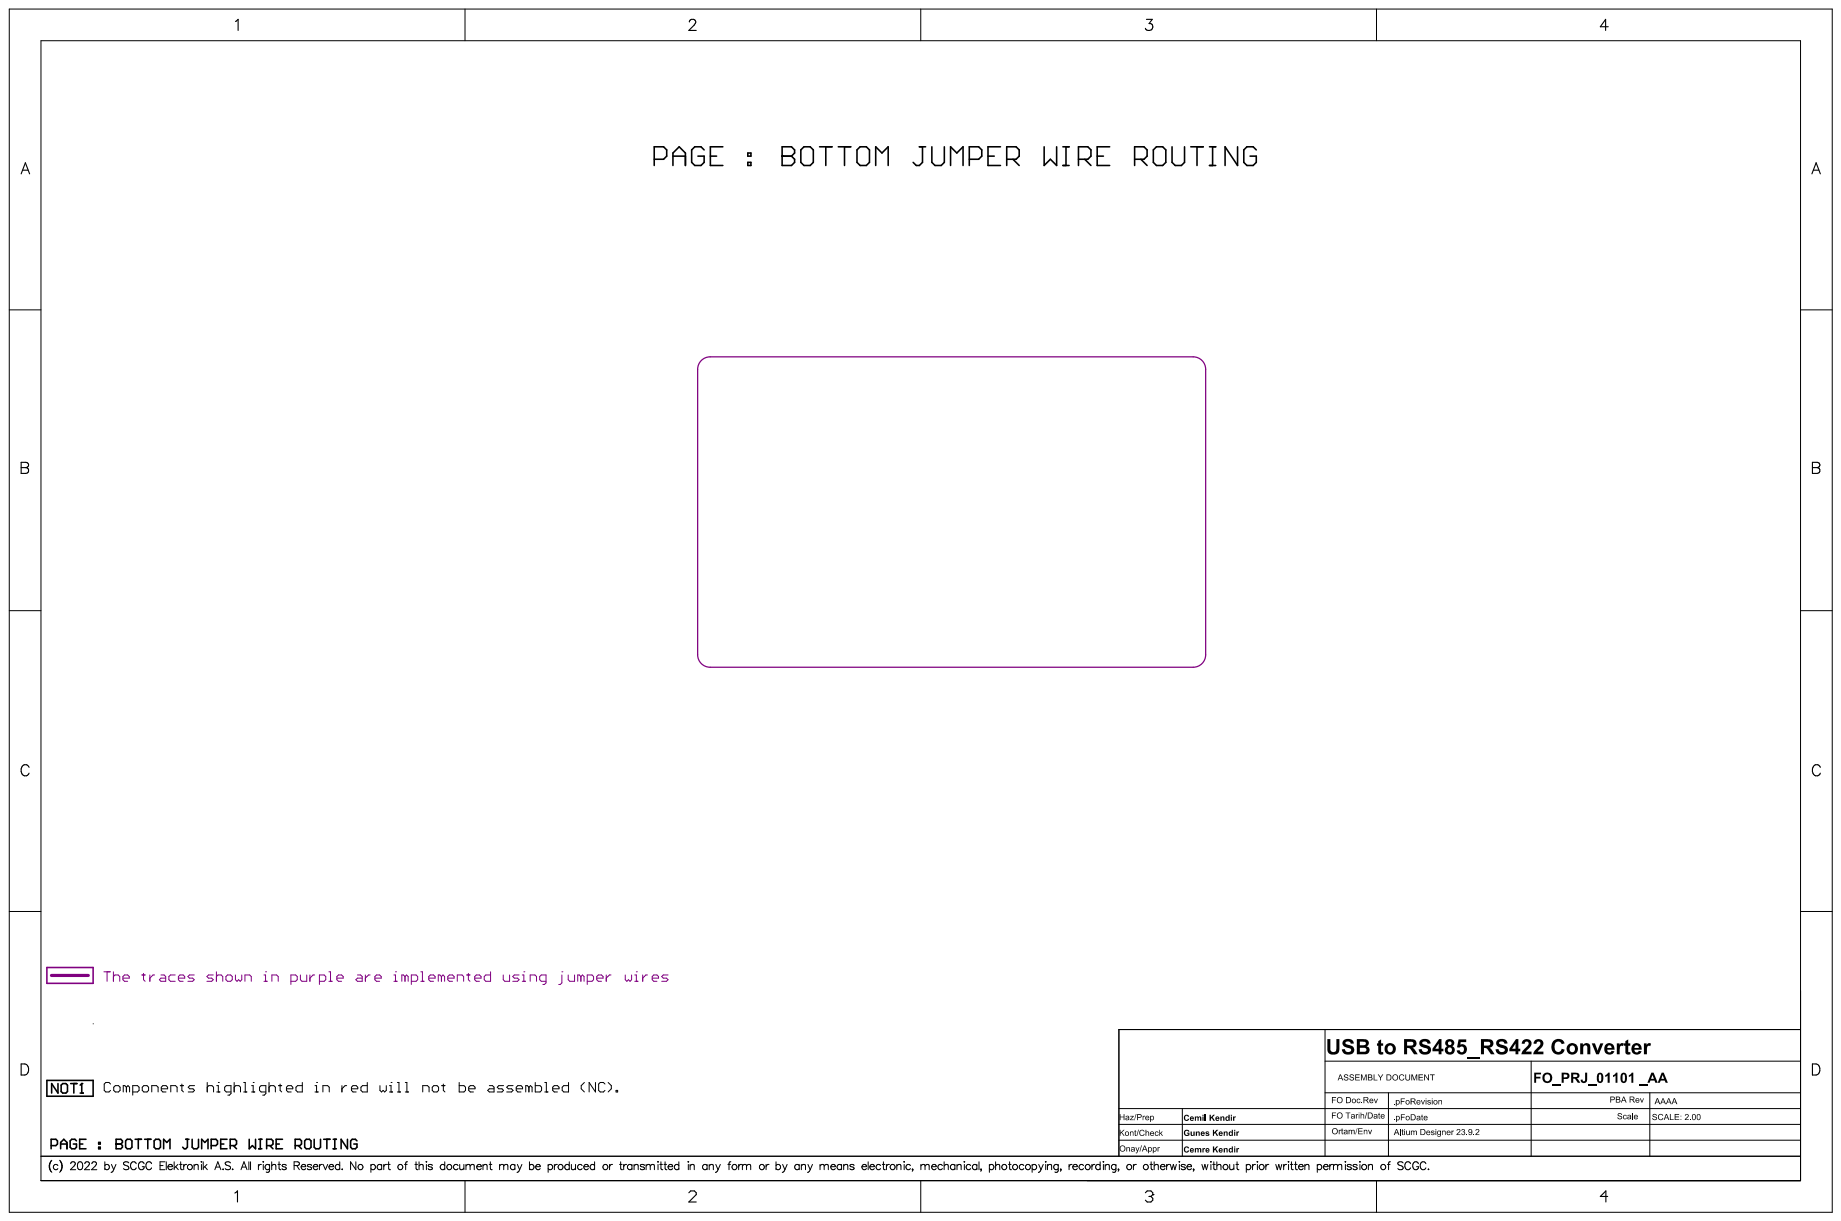
[picture p51: page 13]
