cemilkendir/isolated-usb-rs485-rs422-converter/(list of files, drawings)

Other design files:
A2_Hardware/PCB_0110_01_AA/Isolator.SchDoc
A2_Hardware/PCB_0110_01_AA/pcb/PRJ_0110_AAAA.PcbDoc
A2_Hardware/PCB_0110_01_AA/PRJ_0110_AA.PrjPCB
A2_Hardware/PCB_0110_01_AA/sch/___Main.SchDoc
A2_Hardware/PCB_0110_01_AA/sch/Header.SchDoc
A2_Hardware/PCB_0110_01_AA/sch/Isolator.SchDoc
A2_Hardware/PCB_0110_01_AA/sch/Main.SchDoc
A2_Hardware/PCB_0110_01_AA/sch/RS485.SchDoc
A2_Hardware/PCB_0110_01_AA/sch/UsbToUart.SchDoc
